kalliod/PGKB/Parempi idea.txt

Osta numeropadi eBaysta <10€, uudelleenmappaa näppäimet

Tehdään silti DIY-henkinen USB-HID-laite
