kalliod/PGKB/PCB/Rev 03.00/000018 PGKB Schematic Review.xlsx

Product: | 000018 PGKB Rev 1.00
Review date: | 2023-10-22
Reviewer: | Teemu Latonen
No | Item | Status | Comments
1 | Documentation
1.1 | New components checked for errors | Ok
1.2 | Schematic and test point comments | Ok
1.3 | Revision etc updated | Ok
1.4 | Change history page updated | Ok
2 | General design
2.1 | Check that floating pins are ok to be left floating | Ok
2.2 | Is there room for more bypass capacitors | Ok
2.3 | Design rules | Ok | Not very good
2.4 | Combine R and C values and sizes | Ok
3 | Digital circuits
3.1 | Impedance matching | Ok
3.2 | Logic voltage levels | Ok
3.3 | Logic timings during boot up | Ok
4 | Analog circuits
4.1 | Op amps: Offset voltage, bias current, speed, output load capability | Ok
 | Capacitive loading | Ok
4.2 | Input ranges for analog circuits | Ok
4.3 | Overvoltage situations | Ok
5 | Power circuits
5.1 | Power outputs are short circuit proof | Ok
5.2 | Power input is polarity protected | Ok
5.3 | Fuses and TVSs are added | No
6 | EMC
6.1 | Input and output signals are filtered | No
6.2 | Critical signals (RESET etc) are protected from EMI | Ok
6.3 | Fast signals are suppressed (e.g. high frequency clocks, SMPS) | Ok
6.4 | Emissions from SMPS are analyzed and proper countermeasures used | No
7 | Testing and production
7.1 | Test points, GND connection point | Ok
7.2 | 0 Ohm resistors to isolate circuits | Ok
7.3 | Alignment holes for tester | Ok
7.4 | All parts are RoHS compliant | NA
8 | BOM
8.1 | Component availability and lead times | Ok
