kalliod/PGKB/PCB/Rev 03.00/000018 PGKB Layout Review.xlsx

Product: | 000018 PGKB Rev 1.00
Review date: | 2023-10-22
Reviewer: | Teemu Latonen
No | Item | Status | Comments
1 | Markings
1.1 | PN, revision etc marked on board | Ok
1.2 | Area marked for UL and manufacturer markings | NA
1.3 | Layers marked for 4+ layer boards | Ok
1.4 | Reference designators | Ok
1.5 | PCB Build up in drill drawing | Ok
2 | Design
2.1 | Spark gaps and clearance cut outs | NA
2.2 | Fiducials | Ok
2.3 | Clerances and creepage distances checked | Ok
2.4 | Corners rounded (0.5 mm) | Ok
2.5 | Cable clearances, receptacles fit to connectors | Ok
2.6 | Component clearances | Ok
2.7 | Mounting holes | Ok
2.8 | PCB break away tabs | No
2.9 | Polarization of components (pin 1 marked, connectors labeled) | Ok
2.10 | No traces under conductive components | Ok
2.11 | No direct traces between adjacent pads of IC, if not covered by solder mask | Ok
2.12 | Tester guidance holes | Ok
2.13 | > 5 mm distance between test points | No
2.14 | Reset traces short | Ok
2.15 | Ground planes for analog circuits | Ok
2.16 | Impedance matching | Ok
2.17 | Area for heat sinks or exposed copper on PCB | Ok
2.18 | Wave soldering requirements | No
2.19 | Hand soldering requirements | Ok
3 | Documents
3.1 | BOM
3.2 | Gerbers
3.3 | Placement ASCII file
3.4 | Assembly drawing
3.5 | .pdfs of gerber files
3.6 | Drill files
4 | OTHER
4.1 | PCB and silk color
4.2 | Surface finish
4.3 | PCB specification file
4.4 | Mark the files with date
