kalliod/PGKB/ButtonSupport/Rev 01.00/ButtonSupport/Mechanical/buttonSupport.dxf

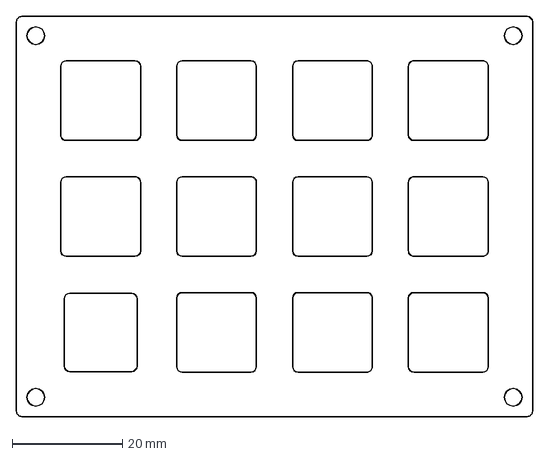
[picture p1: CAD file, 2023-10-17]
ButtonSupport/Rev 01.00/ButtonSupport/Mechanical/buttonSupport.dxf
93.5 x 72.5 mm
