kalliod/PGKB/Enclosure/Enclosure_bottom.stl

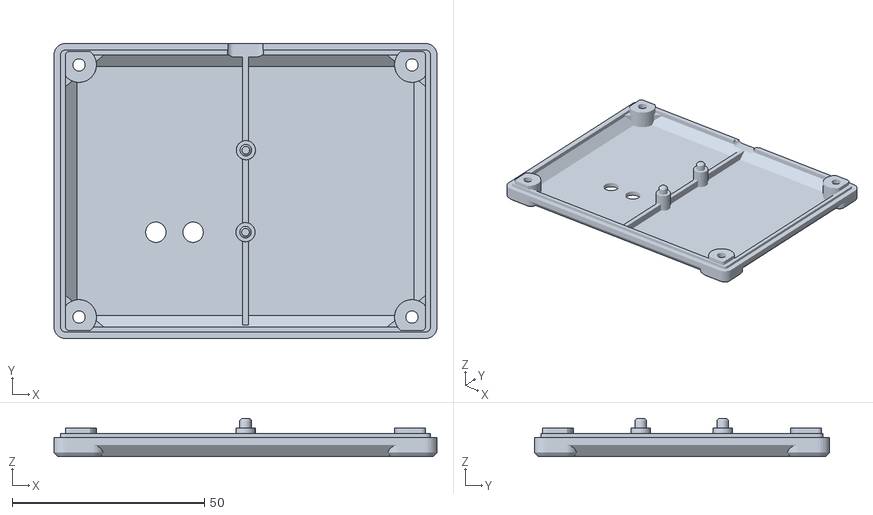
[picture p2: CAD file, 2024-08-26]
Enclosure/Enclosure_bottom.stl
99.5 x 76.7 x 9.90
