kalliod/PGKB/Enclosure/MX_Key_Template_Square v2.stl

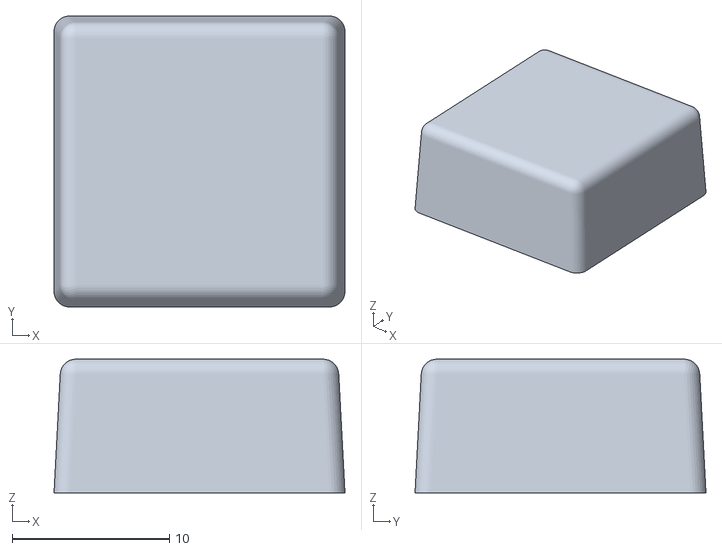
[picture p3: CAD file, 2024-08-26]
Enclosure/MX_Key_Template_Square v2.stl
18.5 x 18.5 x 8.50
