kalliod/PGKB/Enclosure/Encoder_knob.stl

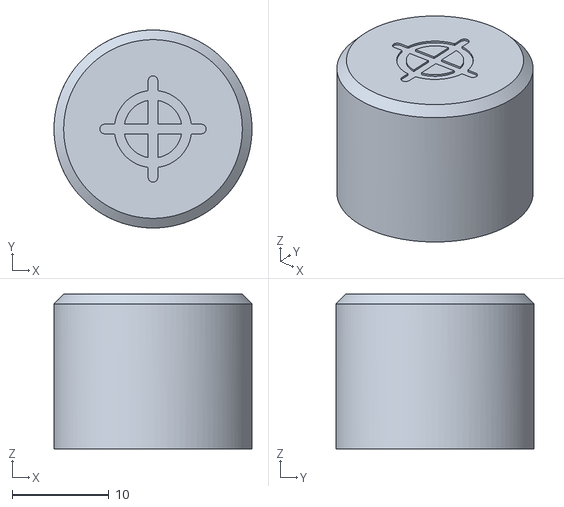
[picture p4: CAD file, 2024-08-26]
Enclosure/Encoder_knob.stl
20.5 x 20.5 x 16.0
