kalliod/PGKB/Enclosure/Enclosure_top.stl

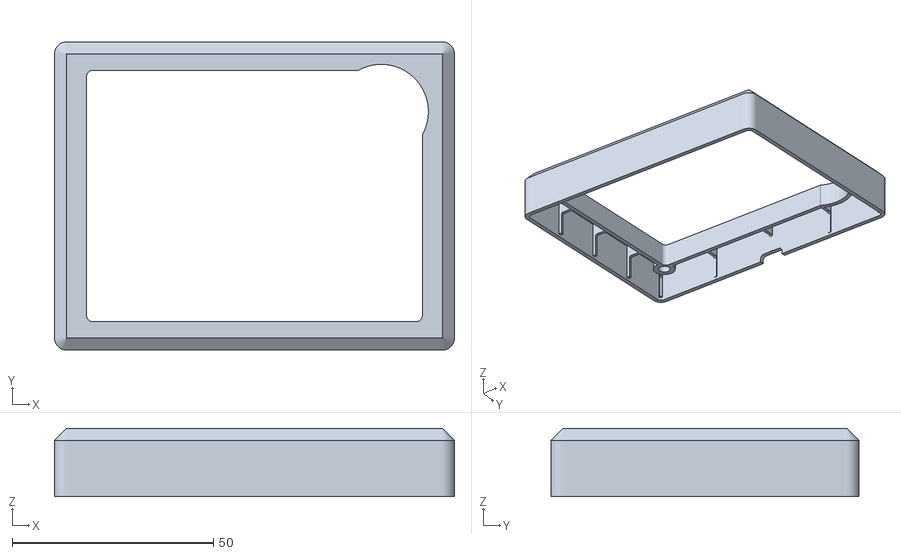
[picture p5: CAD file, 2024-08-26]
Enclosure/Enclosure_top.stl
99.5 x 76.7 x 17.0
