kalliod/PGKB/PCB/Rev 02.00/000018 PGKB/Mechanical/RST Button v1.stl

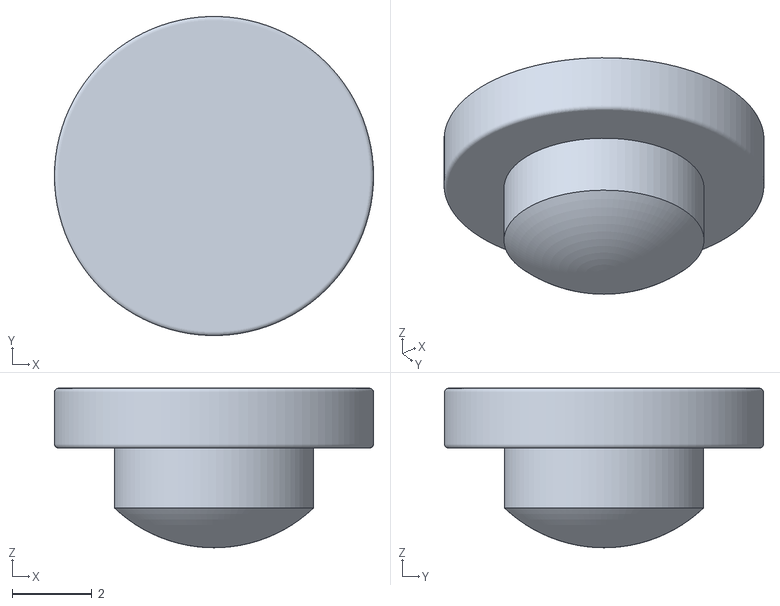
[picture p6: CAD file, 2024-08-26, an earlier design]
PCB/Rev 02.00/000018 PGKB/Mechanical/RST Button v1.stl
8.00 x 8.00 x 4.00
