kalliod/PGKB/PCB/Rev 02.00/000018 PGKB/Mechanical/Insert M3 D5 L5mm.stp

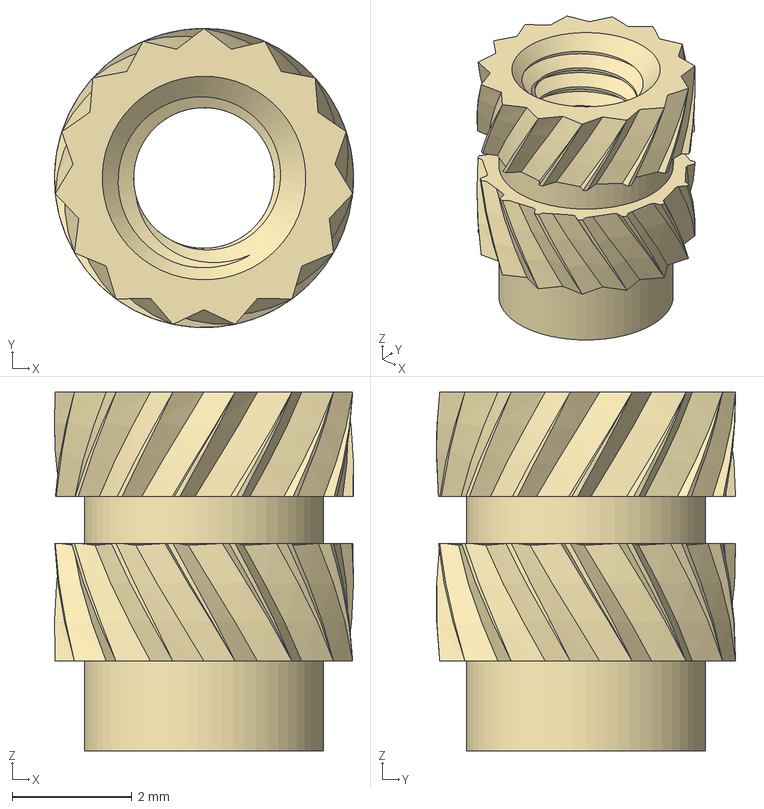
[picture p7: CAD file, 2023-10-23, an earlier design]
PCB/Rev 02.00/000018 PGKB/Mechanical/Insert M3 D5 L5mm.stp
5.00 x 5.00 x 6.00 mm
