kalliod/PGKB/PCB/Rev 02.00/000018 PGKB/Mechanical/Board Outline_V2.dxf

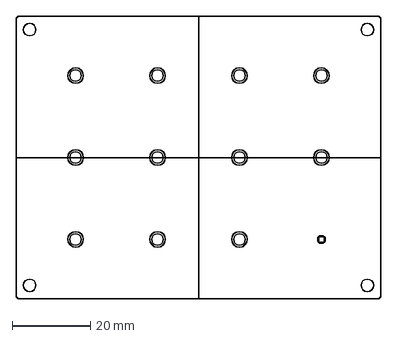
[picture p8: CAD file, 2023-10-17, an earlier design]
PCB/Rev 02.00/000018 PGKB/Mechanical/Board Outline_V2.dxf
93.5 x 72.5 mm
