kalliod/PGKB/PCB/Rev 02.00/000018 PGKB/Mechanical/Board Outline.dxf

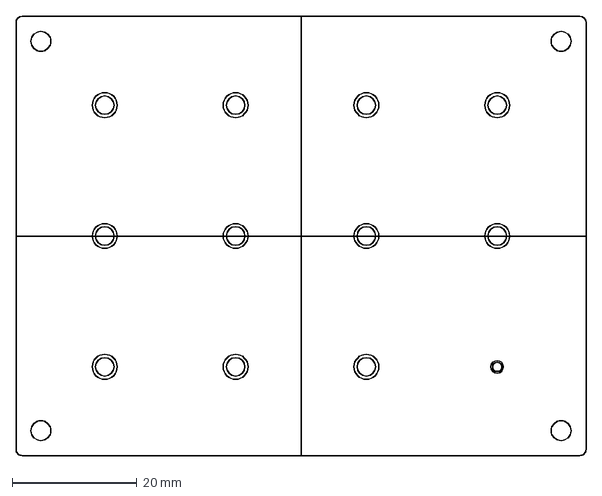
[picture p9: CAD file, 2023-10-16, an earlier design]
PCB/Rev 02.00/000018 PGKB/Mechanical/Board Outline.dxf
91.5 x 70.5 mm
