kalliod/PGKB/(list of files, cad)

Other CAD files:
PCB/Rev 02.00/000018 PGKB/Mechanical/Enclosure_top_V2.stl
PCB/Rev 02.00/000018 PGKB/Mechanical/Enclosure_top.step
PCB/Rev 02.00/000018 PGKB/Mechanical/MX_cap.stl
PCB/Rev 02.00/000018 PGKB/Mechanical/Enclosure_bottom_V2.stl
PCB/Rev 02.00/000018 PGKB/Mechanical/Enclosure_bottom.step
PCB/Rev 02.00/000018 PGKB/Mechanical/Encoder_knob.stl
Enclosure/Enclosure_bottom.f3d
Enclosure/Encoder_knob.f3d
Enclosure/MX_Key_Template_Square v2.f3d
PCB/Rev 02.00/000018 PGKB/Mechanical/Enclosure_bottom.stl
PCB/Rev 02.00/000018 PGKB/Mechanical/Enclosure_top.stl
