kalliod/PGKB/PCB/Rev 03.00/000018 PGKB/000018 PGKB Rev 3.pdf

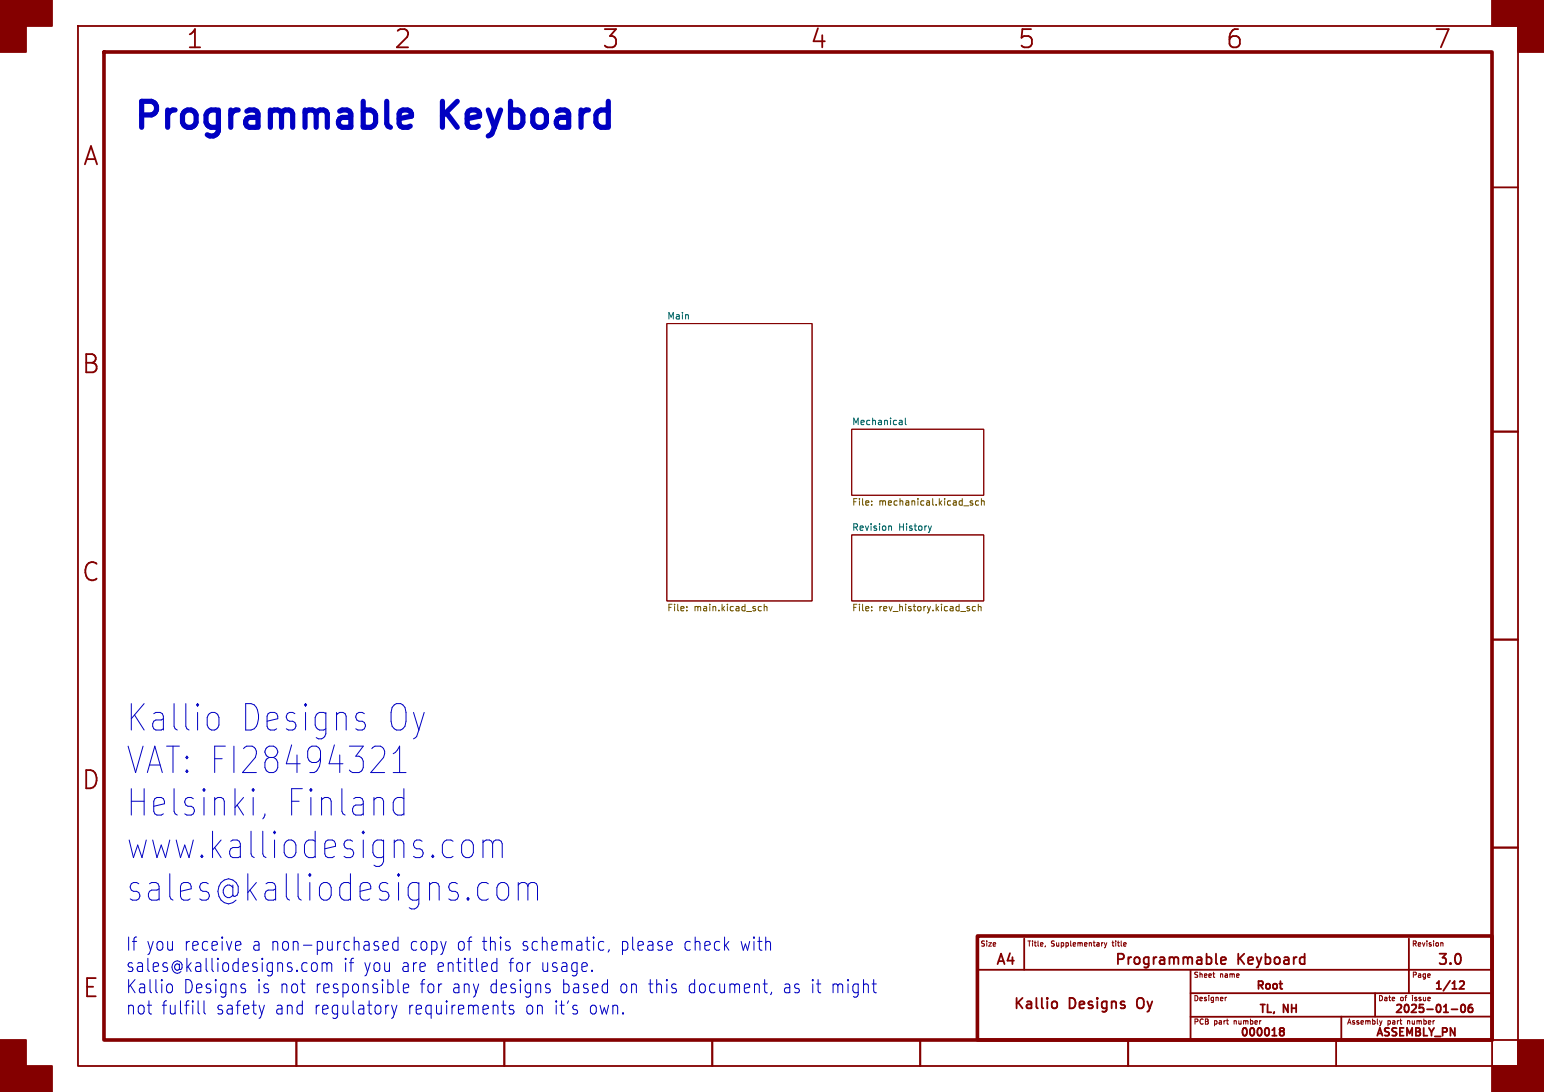
[picture p10: page 1]

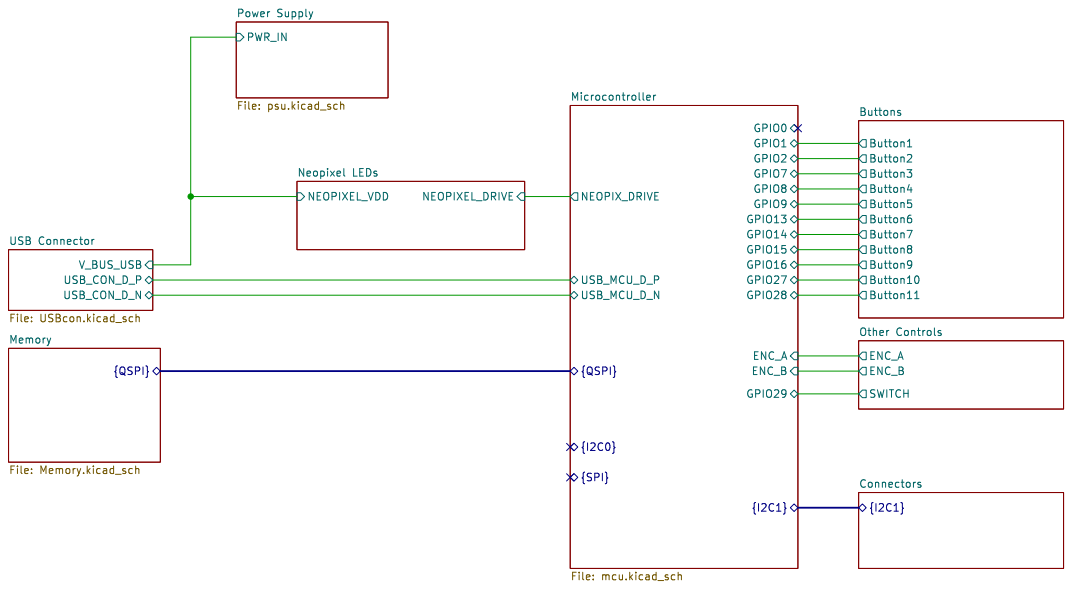
[picture p11: page 2]

Power Supply File: psu.kicad_sch
{I2C1} GPIO8 GPIO7 GPIO9 GPIO29 GPIO27 GPIO28 GPIO15 GPIO14 GPIO13 GPIO16 Microcontroller File: mcu.kicad_sch
{SPI} NEOPIX_DRIVE

USB Connector File: USBcon.kicad_sch

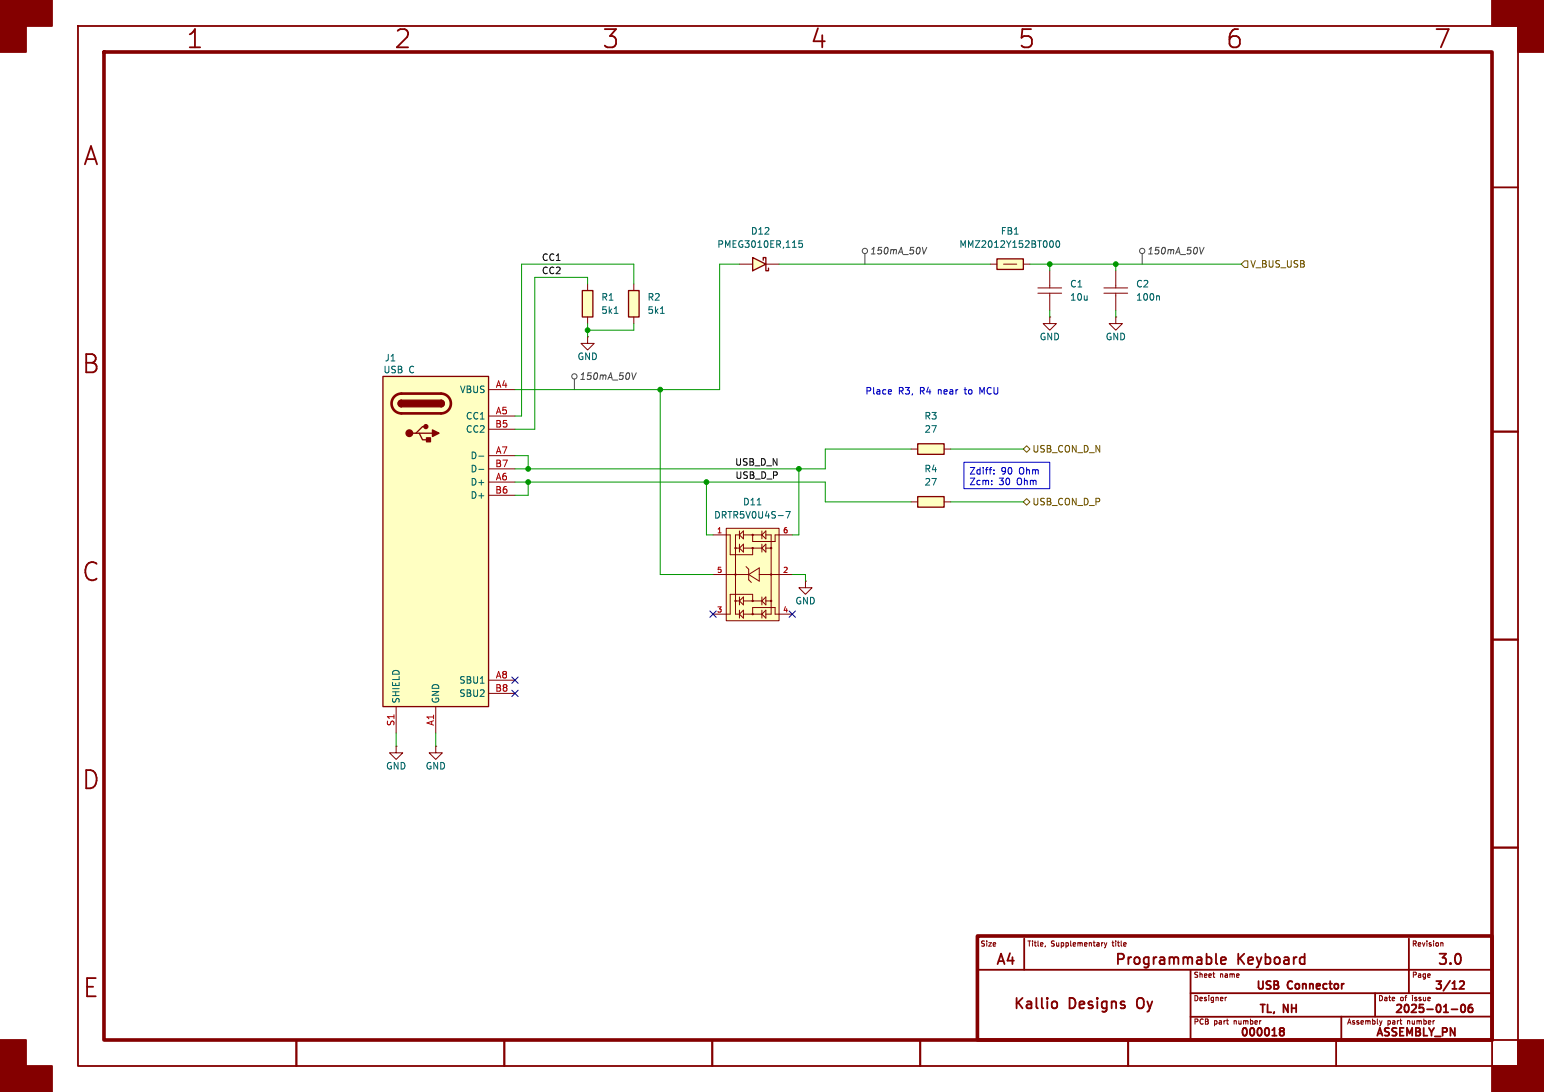
[picture p12: page 3]

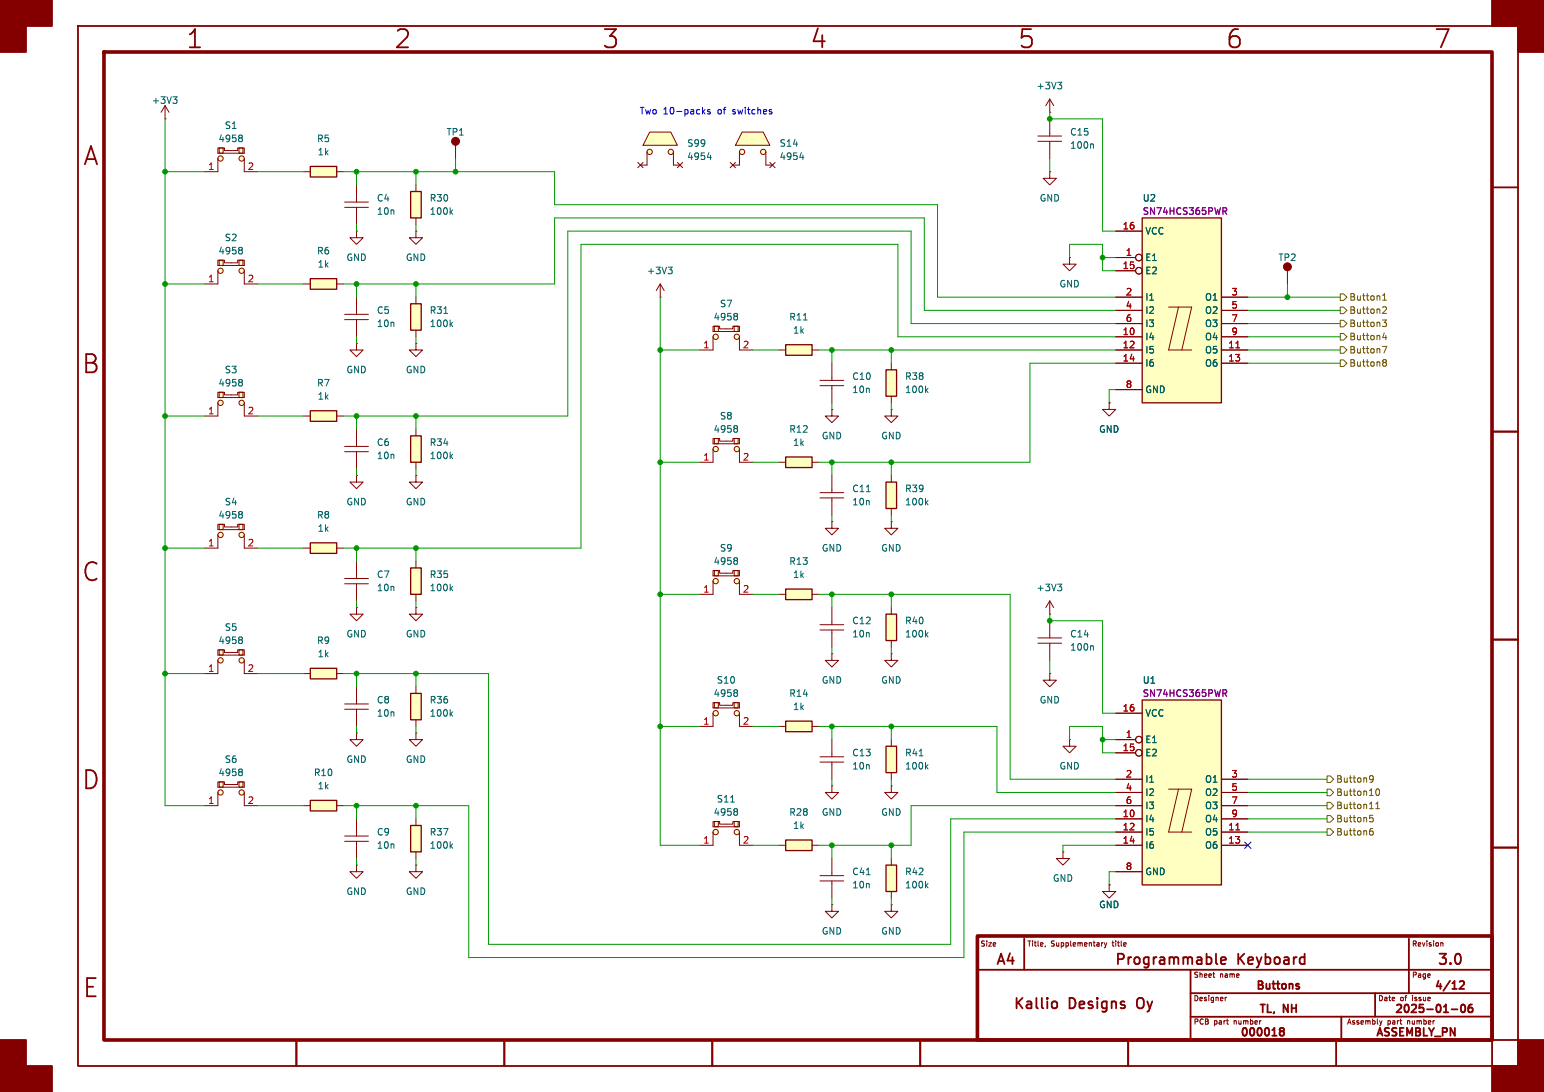
[picture p13: page 4]

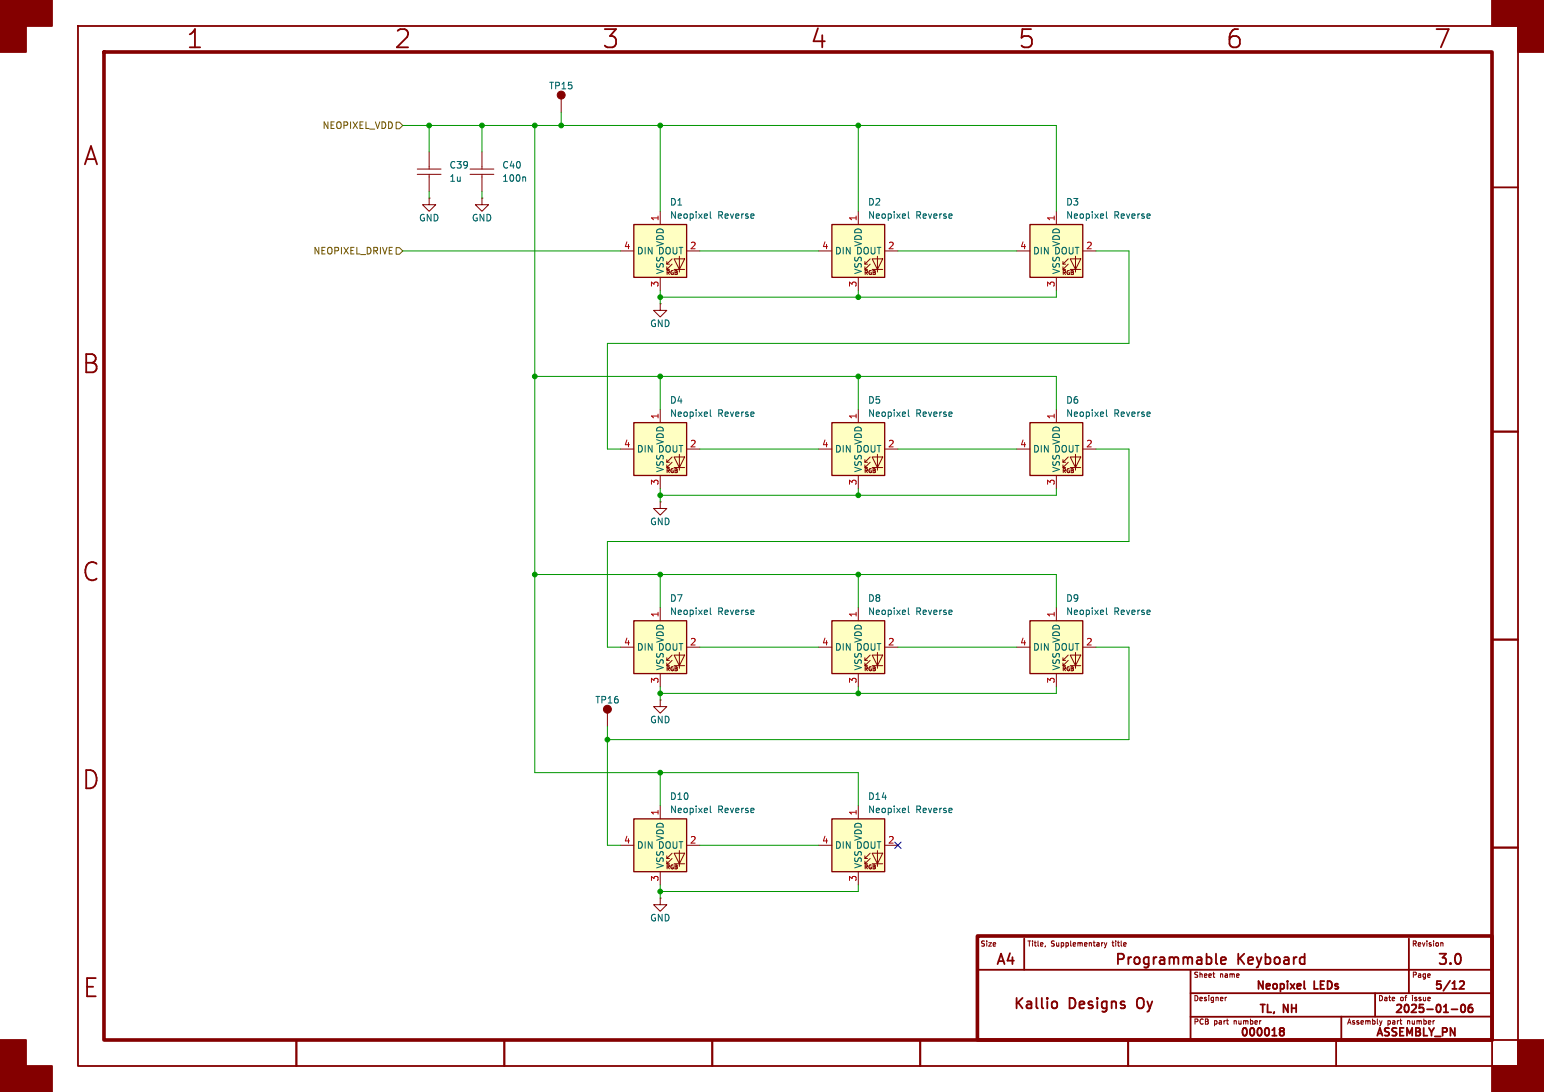
[picture p14: page 5]

3 DIN 4 D1 Neopixel Reverse GND
RGB VDD

3 DIN 4 D2 Neopixel Reverse GND

3 DIN 4 D5 Neopixel Reverse GND

3 DIN 4 D8 Neopixel Reverse GND

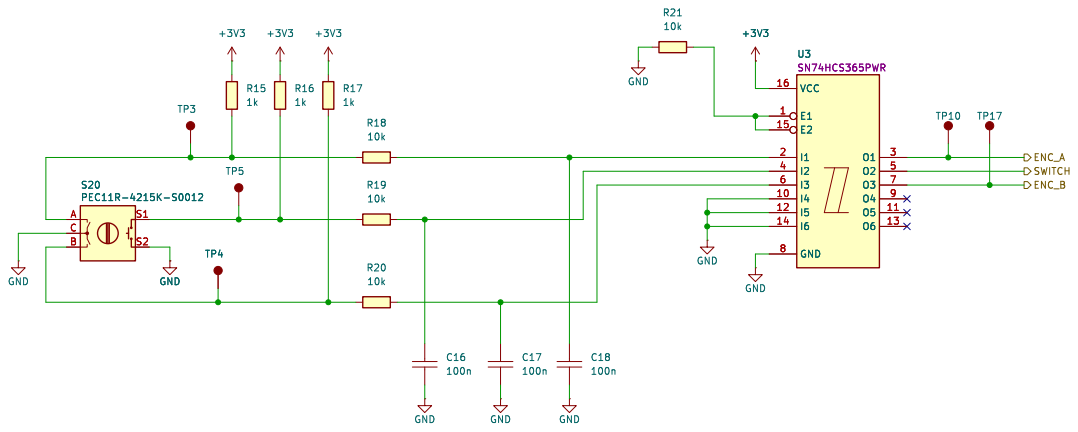
[picture p15: page 6]

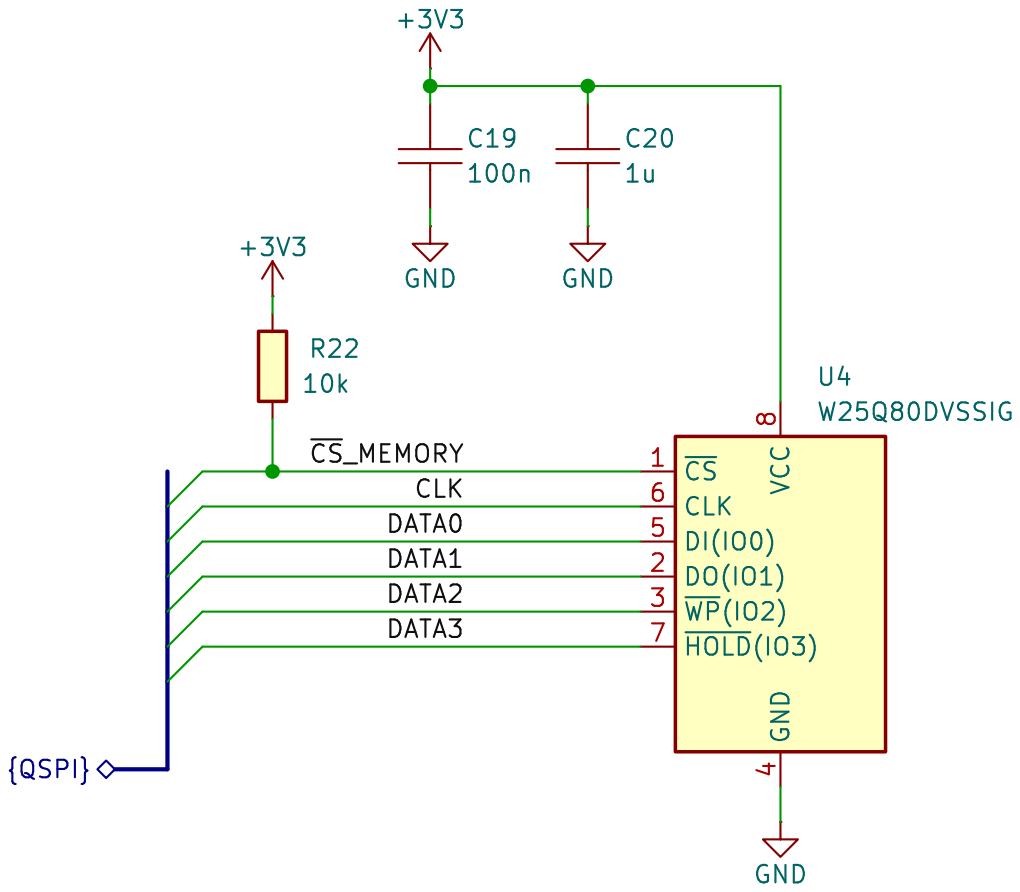
[picture p16: page 7]

4 DI(IO0) 5 CLK 6 ~{HOLD}(IO3) 7 VCC

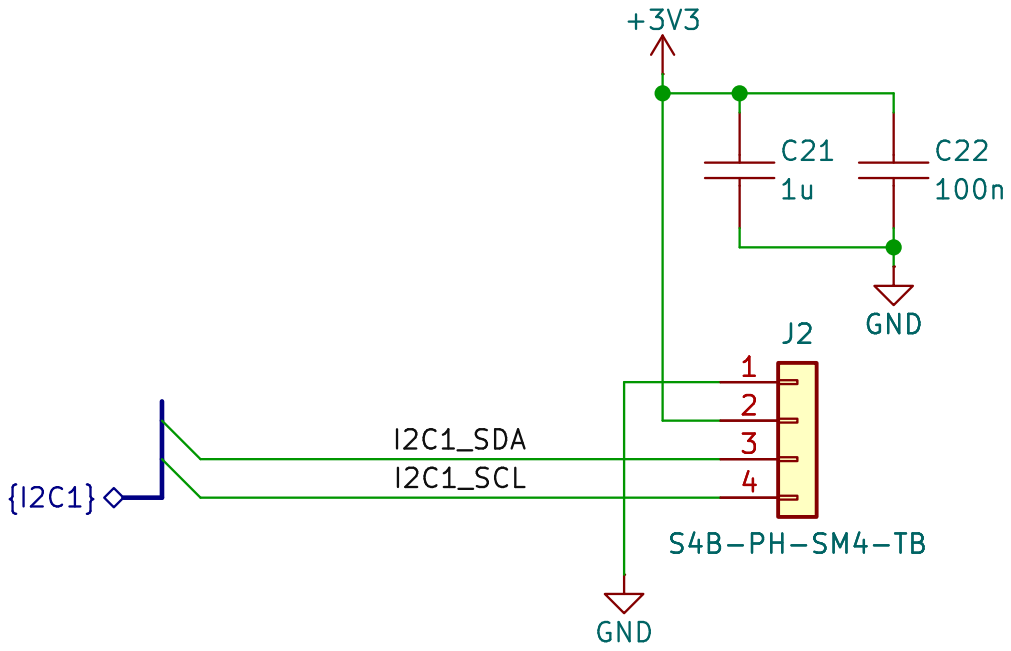
[picture p17: page 8]

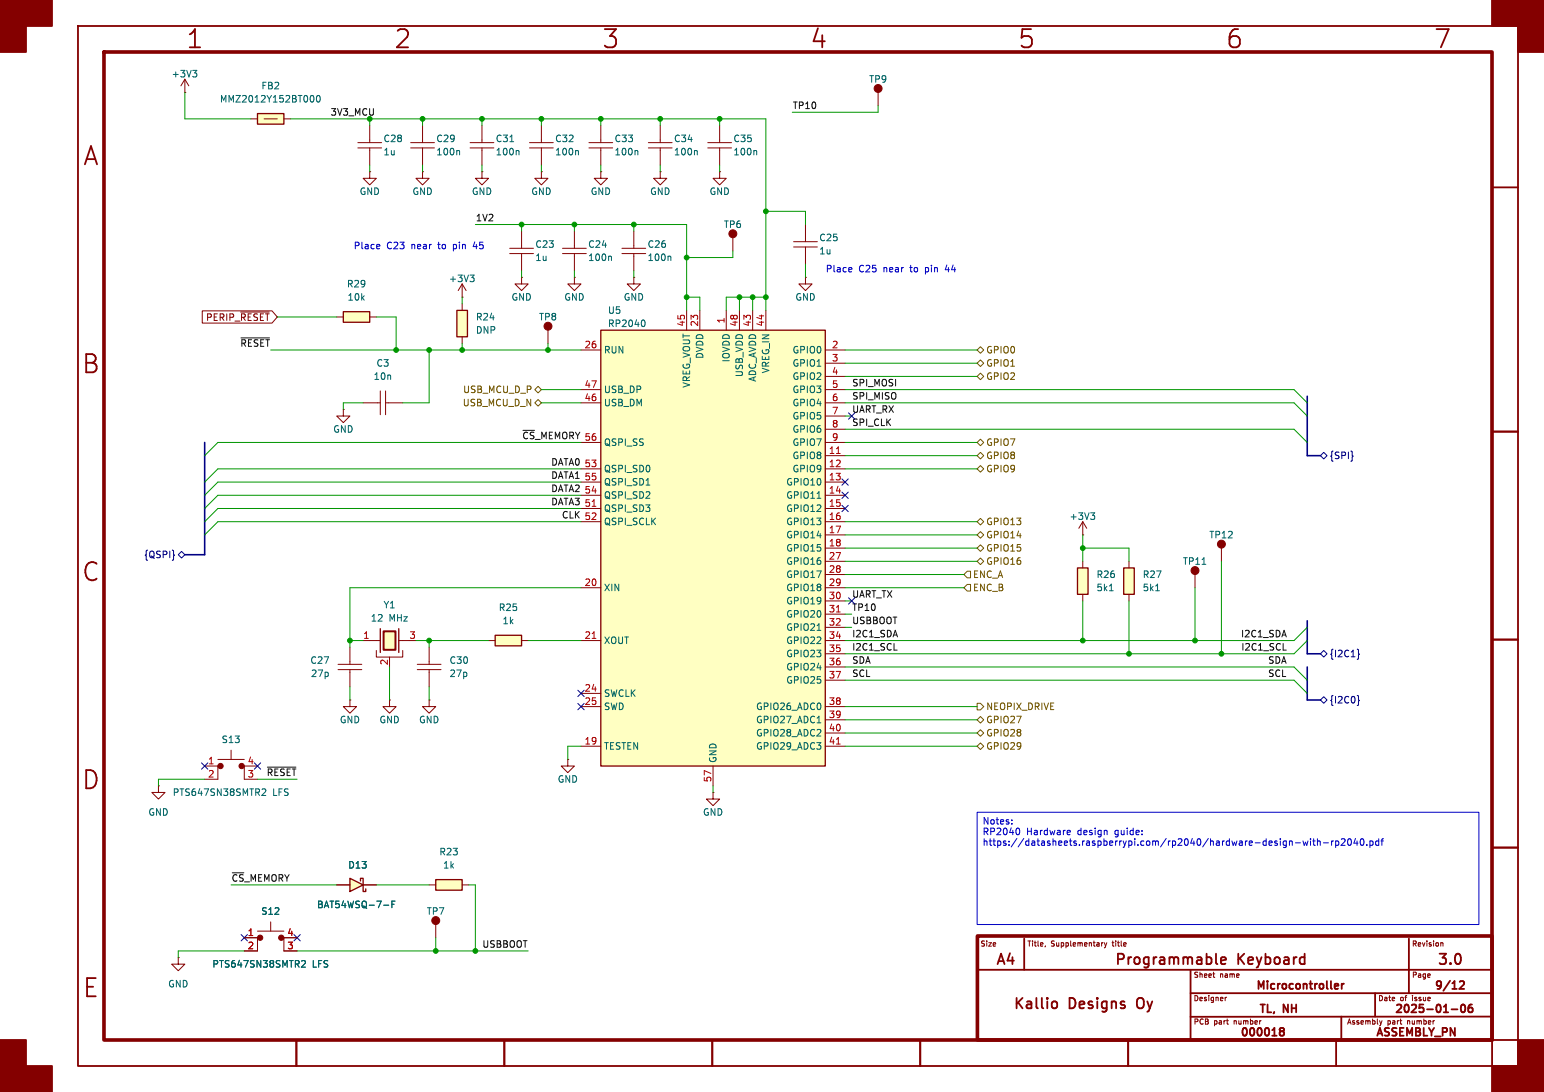
[picture p18: page 9]

1 GPIO8 11 GPIO9 12 GPIO10 13 GPIO11 14 GPIO12 15 GPIO13 16 GPIO14 17 GPIO15 18 TESTEN 19 GPIO0 2 XIN 20 XOUT 21 DVDD 23 SWCLK 24 SWD 25 RUN 26 GPIO16 27 GPIO17 28 GPIO18 29 GPIO1 3 GPIO19 30 GPIO20 31 GPIO21 32 GPIO22 34 GPIO23 35 GPIO24 36 GPIO25 37 GPIO26_ADC0 38 GPIO27_ADC1 39 GPIO2 4 GPIO28_ADC2 40 GPIO29_ADC3 41 ADC_AVDD 43 VREG_IN 44 VREG_VOUT 45 USB_DM 46 USB_DP 47 USB_VDD 48 GPIO3 5 QSPI_SD3 51 QSPI_SCLK 52 QSPI_SD0 53 QSPI_SD2 54 QSPI_SD1 55 QSPI_SS 56 GND 57 GPIO4 6 GPIO5 7 GPIO6 8 GPIO7 9 U5 RP2040 D13 BAT54WSQ-7-F

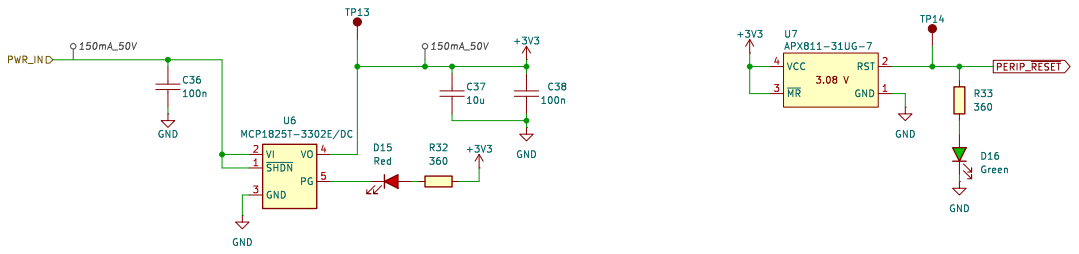
[picture p19: page 10]

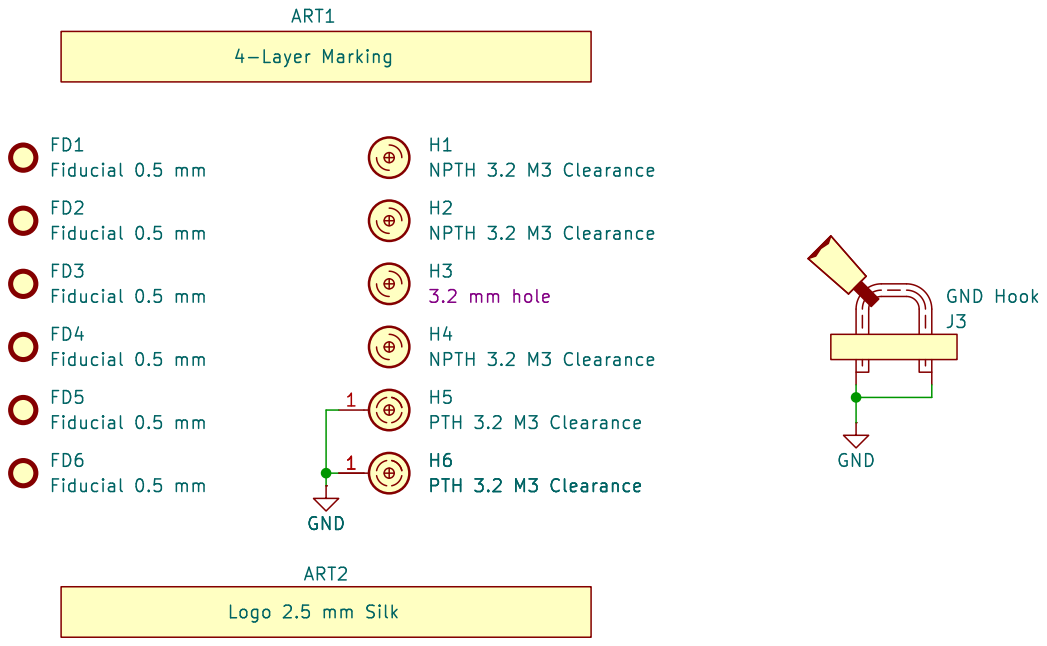
[picture p20: page 11]

Logo 2.5 mm Silk GND

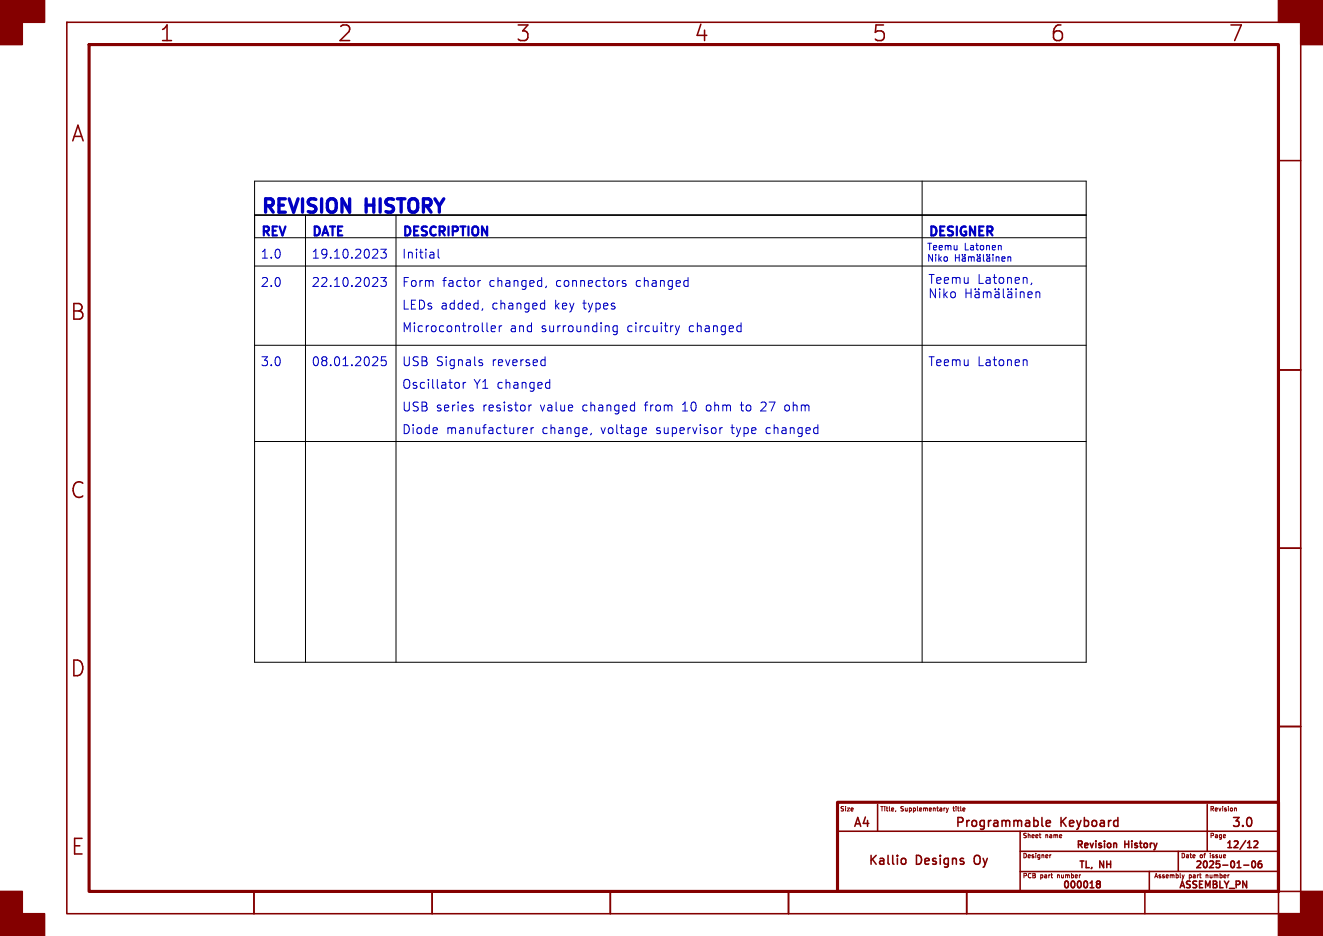
[picture p21: page 12]

2.0 | 08.01.2025 22.10.2023 | Teemu Latonen 3.0 Teemu Latonen,

Teemu Latonen
