kalliod/PGKB/PCB/Rev 01.01/000018 PGKB Rev 2.00.pdf

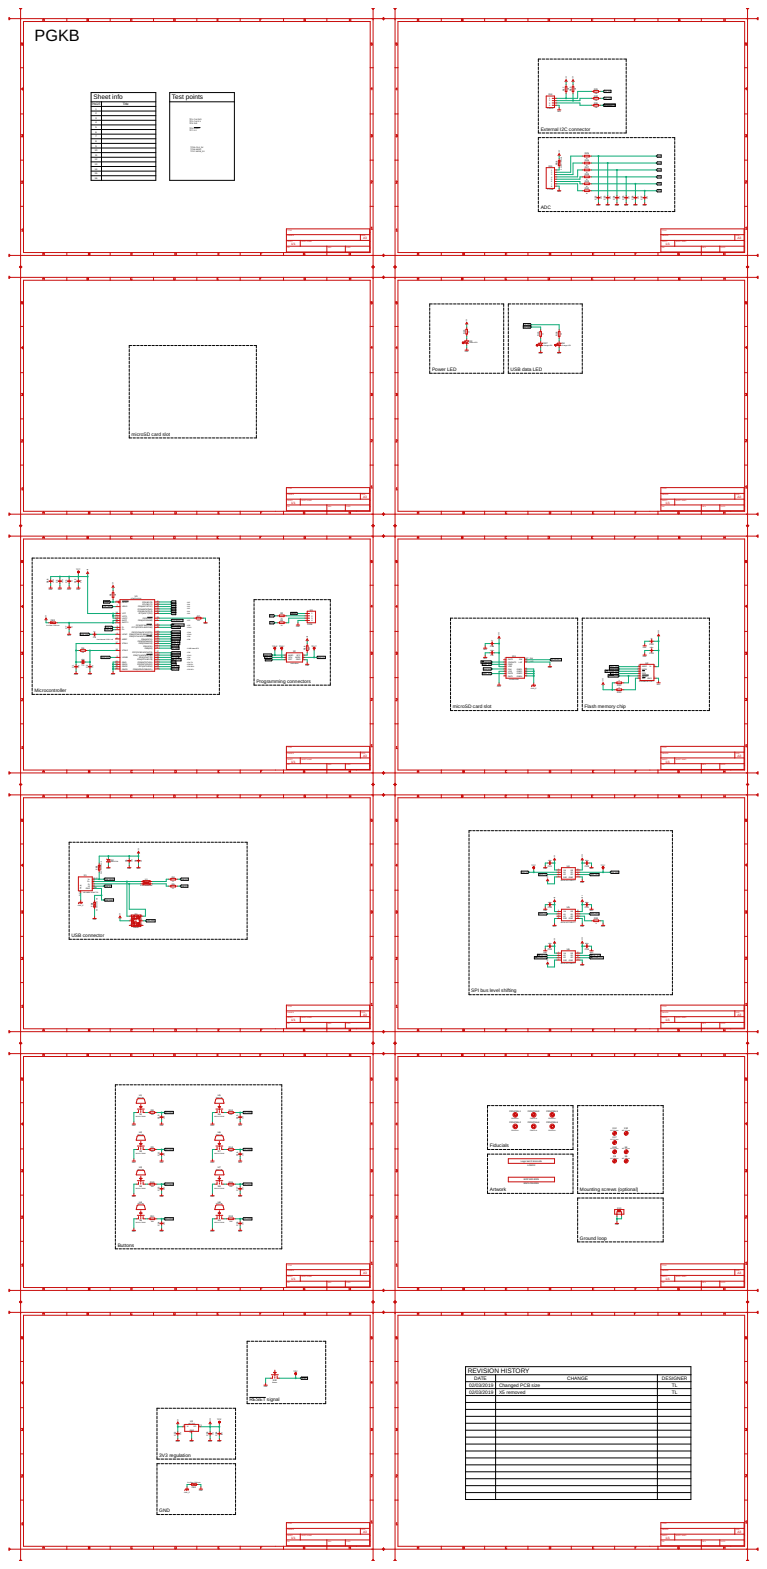
[picture p22: page 1]

OWNER: | SIZE: A3

SHEET: PN: | REV: DATE: SHEET NAME: 1/1

SPI bus level shifting

DATE | CHANGE | DESIGNER
02/03/2019 | Changed PCB size | TL
02/03/2019 | X5 removed | TL
