kalliod/PGKB/PCB/Rev 03.00/000018 PGKB/000018 PGKB.kicad_pcb

## KiCad design PCB/Rev 03.00/000018 PGKB/000018 PGKB.kicad_pcb (2025-01-08)

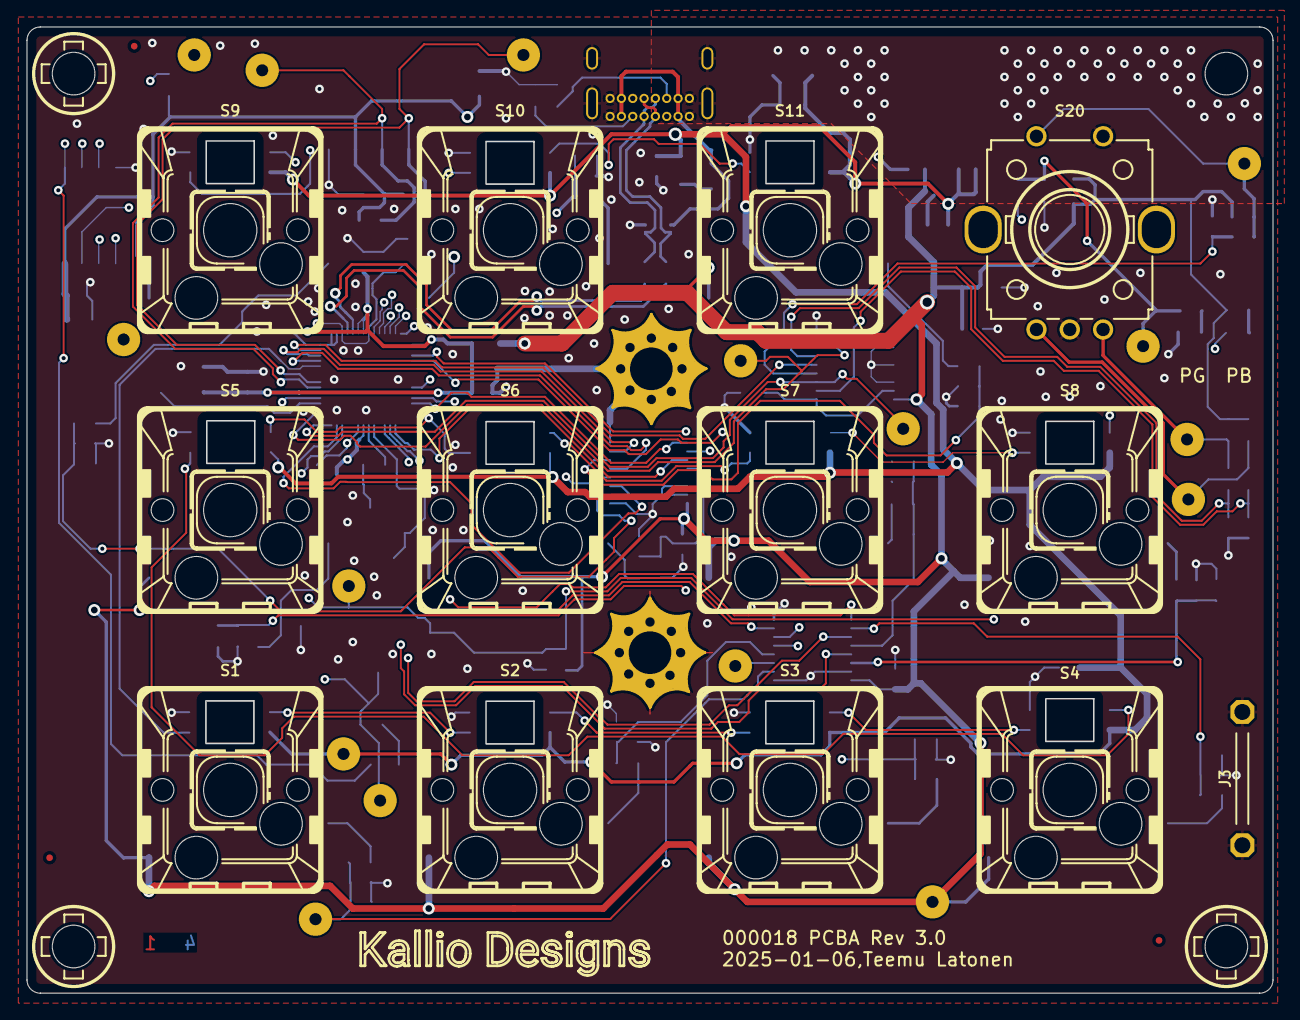
[picture p23: board 000018 PGKB.kicad_pcb from above]

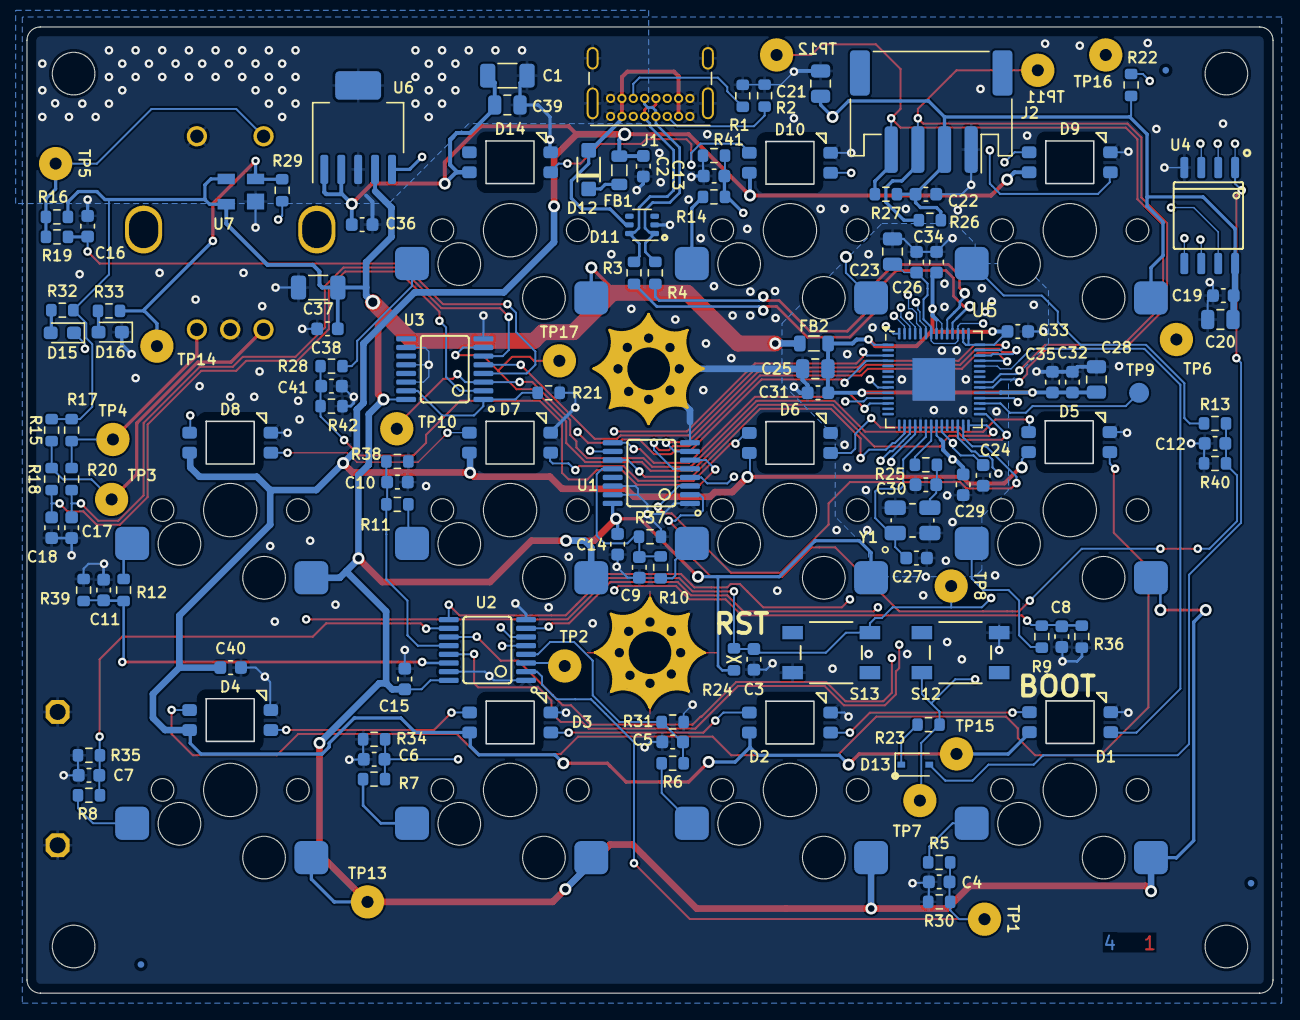
[picture p24: board 000018 PGKB.kicad_pcb from below]

Board: 4 copper layers, 93.5 x 72.5 mm, 157 parts (133 on the bottom side), 86 nets.

Parts:
ART1: 4-Layer Marking; ART_4-LAYER
ART2: Logo 2.5 mm Silk; ART_LOGO_TEXT_2.5MM_SILK
C1, C37: 10u; CAPC3216X150N
C2, C14, C15, C16, C17, C18, C19, C22, C24, C26, C29, C31, C32, C33, C34, C35, C36, C38, C40: 100n; CAPC1608X90N
C3, C4, C5, C6, C7, C8, C9, C10, C11, C12, C13, C41: 10n; CAPC1608X90N
C20, C21, C23, C25, C28, C39: 1u; CAPC2012X135N
C27, C30: 27p; CAPC1608X90N
D1, D2, D3, D4, D5, D6, D7, D8, D9, D10, D14: Neopixel Reverse; LEDM_NEO3535_REVERSE_SK6812-E
D11: DRTR5V0U4S-7; SOT-363_SC-70-6
D12: PMEG3010ER,115; DIOC360X180X150N_A
D13: BAT54WS; D_SOD-323
D15: Red; LEDM1608X70M
D16: Green; LEDM1608X70M
FB1, FB2: MMZ2012Y152BT000; INDC2016X100N
FD1, FD2, FD3, FD4, FD5, FD6: Fiducial 0.5 mm; Fiducial_0.5mm_Mask1mm
H1, H2, H4: NPTH 3.2 M3 Clearance; NPTH_3.2mm_M3_clearance
H3: NPTH_3.2; NPTH_3.2mm
H5, H6: PTH 3.2 M3 Clearance; PTH_3.2mm_M3_clearance_B
J1: USB C; USB_C_Receptacle_GCT_USB4085
J2: S4B-PH-SM4-TB; JST_PH_S4B-PH-SM4-TB_1x04-1MP_P2.00mm_Horizontal
J3: GND Hook; GND_HOOK_M
R1, R2, R26, R27: 5k1; RESC1608X55N
R3, R4: 27; RESC1608X55N
R5, R6, R7, R8, R9, R10, R11, R12, R13, R14, R15, R16, R17, R23, R25, R28: 1k; RESC1608X55N
R18, R19, R20, R21, R22, R29: 10k; RESC1608X55N
R24: DNP; RESC1608X55N_DNP
R30, R31, R34, R35, R36, R37, R38, R39, R40, R41, R42: 100k; RESC1608X55N
R32, R33: 360; RESC1608X55N
S1, S2, S3, S4, S5, S6, S7, S8, S9, S10, S11: 4958; SWITCH_BUTTON_Kailh_mx_socket
S12, S13: PTS647SN38SMTR2 LFS; SW_Push_1P1T_NO_CK_PTS647SN50SMTR2LFS
S20: PEC11R-4215K-S0012; RotaryEncoder_Bourns_Vertical_PEC11R-4x15f-Sxxxx
TP1, TP2, TP3, TP4, TP5, TP6, TP7, TP8, TP10, TP11, TP12, TP13, TP14, TP15, TP16, TP17: TP D2.5 mm H0.9mm; TestPoint_Pad_D2.5mm_H0.9mm
TP9: TestPoint_1.5mm_Round; TestPoint_Pad_D1.5mm
U1, U2, U3: SN74HCS365PWR; SOP65P600X150-16N
U4: W25Q80DVSSIG; SOIC127P790X195-8N
U5: RP2040; QFN-56-1EP_7x7mm_P0.4mm_EP3.2x3.2mm
U6: MCP1825T-3302E/DC; SOT127P700X180-6N
U7: CAT811TTBI-GT3; SOT-143_TO-253_M
Y1: 12 MHz; OSCCC320X250X70_M

Connections:
+3V3: C14.1, C15.1, C19.1, C20.1, C21.1, C22.1, C37.1, C38.1, FB2.1, J2.2, R15.1, R16.1, R17.1, R22.1, R24.2, R26.1, R27.1, R32.2, S1.1, S2.1, S3.1, S4.1, S5.1, S6.1, S7.1, S8.1, S9.1, S10.1, S11.1, TP13.1, U1.16 (VCC), U2.16 (VCC), U3.16 (VCC), U4.8 (VCC), U6.4 (VO), U7.3 (~MR), U7.4 (VCC)
/Main/Buttons/Button1: TP2.1, U2.3 (O1), U5.3 (GPIO1)
/Main/Buttons/Button2: U2.5 (O2), U5.4 (GPIO2)
/Main/Buttons/Button3: U2.7 (O3), U5.9 (GPIO7)
/Main/Buttons/Button4: U2.9 (O4), U5.11 (GPIO8)
/Main/Buttons/Button5: U1.9 (O4), U5.12 (GPIO9)
/Main/Buttons/Button6: U1.11 (O5), U5.16 (GPIO13)
/Main/Buttons/Button7: U2.11 (O5), U5.17 (GPIO14)
/Main/Buttons/Button8: U2.13 (O6), U5.18 (GPIO15)
/Main/Buttons/Button9: U1.3 (O1), U5.27 (GPIO16)
/Main/Buttons/Button10: U1.5 (O2), U5.39 (GPIO27_ADC1)
/Main/Buttons/Button11: U1.7 (O3), U5.40 (GPIO28_ADC2)
/Main/Connectors/I2C1_SCL: J2.4, R27.2, TP12.1, U5.35 (GPIO23)
/Main/Connectors/I2C1_SDA: J2.3, R26.2, TP11.1, U5.34 (GPIO22)
/Main/Memory/CLK: U4.6 (CLK), U5.52 (QSPI_SCLK)
/Main/Memory/DATA0: U4.5 (DI(IO0)), U5.53 (QSPI_SD0)
/Main/Memory/DATA1: U4.2 (DO(IO1)), U5.55 (QSPI_SD1)
/Main/Memory/DATA2: U4.3 (~WP(IO2)), U5.54 (QSPI_SD2)
/Main/Memory/DATA3: U4.7 (~HOLD(IO3)), U5.51 (QSPI_SD3)
/Main/Memory/~CS_MEMORY: D13.2 (A), R22.2, U4.1 (~CS), U5.56 (QSPI_SS)
/Main/Microcontroller/1V2: C23.1, C24.1, C26.1, TP6.1, U5.23 (DVDD), U5.45 (VREG_VOUT), U5.50 (DVDD)
/Main/Microcontroller/3V3_MCU: C25.1, C28.1, C29.1, C31.1, C32.1, C33.1, C34.1, C35.1, FB2.2, U5.1 (IOVDD), U5.10 (IOVDD), U5.22 (IOVDD), U5.33 (IOVDD), U5.42 (IOVDD), U5.43 (ADC_AVDD), U5.44 (VREG_IN), U5.48 (USB_VDD), U5.49 (IOVDD)
/Main/Microcontroller/ENC_A: TP10.1, U3.3 (O1), U5.28 (GPIO17)
/Main/Microcontroller/ENC_B: TP17.1, U3.7 (O3), U5.29 (GPIO18)
/Main/Microcontroller/GPIO29: U3.5 (O2), U5.41 (GPIO29_ADC3)
/Main/Microcontroller/NEOPIX_DRIVE: D1.4 (DIN), U5.38 (GPIO26_ADC0)
/Main/Microcontroller/TP10: TP9.1, U5.31 (GPIO20)
/Main/Microcontroller/USBBOOT: R23.2, S12.3, TP7.1, U5.32 (GPIO21)
/Main/Microcontroller/USB_MCU_D_N: R3.2, U5.46 (USB_DM)
/Main/Microcontroller/USB_MCU_D_P: R4.2, U5.47 (USB_DP)
/Main/Microcontroller/~RESET: C3.2, R24.1, R29.2, S13.3, TP8.1, U5.26 (RUN)
/Main/Neopixel LEDs/NEOPIXEL_VDD: C1.1, C2.1, C36.1, C39.1, C40.1, D1.1 (VDD), D2.1 (VDD), D3.1 (VDD), D4.1 (VDD), D5.1 (VDD), D6.1 (VDD), D7.1 (VDD), D8.1 (VDD), D9.1 (VDD), D10.1 (VDD), D14.1 (VDD), FB1.2, TP15.1, U6.1 (~SHDN), U6.2 (VI)
/Main/USB Connector/CC1: J1.A5 (CC1), R2.1
/Main/USB Connector/CC2: J1.B5 (CC2), R1.1
/Main/USB Connector/USB_D_N: D11.6, J1.A7 (D-), J1.B7 (D-), R3.1
/Main/USB Connector/USB_D_P: D11.1, J1.A6 (D+), J1.B6 (D+), R4.1
GND: C1.2, C2.2, C3.1, C4.2, C5.2, C6.2, C7.2, C8.2, C9.2, C10.2, C11.2, C12.2, C13.2, C14.2, C15.2, C16.1, C17.1, C18.1, C19.2, C20.2, C21.2, C22.2, C23.2, C24.2, C25.2, C26.2, C27.2, C28.2, C29.2, C30.2, C31.2, C32.2, C33.2, C34.2, C35.2, C36.2, C37.2, C38.2, C39.2, C40.2, C41.2, D1.3 (VSS), D2.3 (VSS), D3.3 (VSS), D4.3 (VSS), D5.3 (VSS), D6.3 (VSS), D7.3 (VSS), D8.3 (VSS), D9.3 (VSS), D10.3 (VSS), D11.2 (V-), D14.3 (VSS), D16.1 (K), H5.1, H6.1, J1.A1 (GND), J1.A12 (GND), J1.B1 (GND), J1.B12 (GND), J1.S1 (SHIELD), J2.1, J3.1, J3.2 (Pin_1), R1.2, R2.2, R21.1, R30.2, R31.2, R34.2, R35.2, R36.2, R37.2, R38.2, R39.2, R40.2, R41.2, R42.2, S12.2, S13.2, S20.C, S20.S2, U1.1 (E1), U1.8 (GND), U1.14 (I6), U1.15 (E2), U2.1 (E1), U2.8 (GND), U2.15 (E2), U3.8 (GND), U3.10 (I4), U3.12 (I5), U3.14 (I6), U4.4 (GND), U5.19 (TESTEN), U5.57 (GND), U6.3 (GND), U6.6 (GND), U7.1 (GND), Y1.2 (GND), Y1.4 (GND)
unnamed: C30.1, R25.1, Y1.3
unnamed: D1.2 (DOUT), D2.4 (DIN)
unnamed: D2.2 (DOUT), D3.4 (DIN)
unnamed: D3.2 (DOUT), D4.4 (DIN)
unnamed: D4.2 (DOUT), D5.4 (DIN)
unnamed: D5.2 (DOUT), D6.4 (DIN)
unnamed: D6.2 (DOUT), D7.4 (DIN)
unnamed: D7.2 (DOUT), D8.4 (DIN)
unnamed: D8.2 (DOUT), D9.4 (DIN)
unnamed: D9.2 (DOUT), D10.4 (DIN), TP16.1
unnamed: D10.2 (DOUT), D14.4 (DIN)
unnamed: D11.5 (V+), D12.2 (A), J1.A4 (VBUS), J1.A9 (VBUS), J1.B4 (VBUS), J1.B9 (VBUS)
unnamed: D12.1 (K), FB1.1
unnamed: D13.1 (K), R23.1
unnamed: D15.2 (A), R32.1
unnamed: D15.1 (K), U6.5 (PG)
unnamed: D16.2 (A), R33.1
unnamed: R5.1, S1.2
unnamed: R6.1, S2.2
unnamed: R7.1, S3.2
unnamed: R8.1, S4.2
unnamed: R9.1, S5.2
unnamed: R10.1, S6.2
unnamed: R11.1, S7.2
unnamed: R12.1, S8.2
unnamed: R13.1, S9.2
unnamed: R14.1, S10.2
unnamed: R15.2, R18.1, S20.A, TP3.1
unnamed: R16.2, R19.1, S20.S1, TP5.1
unnamed: R17.2, R20.1, S20.B, TP4.1
unnamed: R28.1, S11.2
unnamed: C12.1, R13.2, R40.1, U1.2 (I1)
unnamed: C13.1, R14.2, R41.1, U1.4 (I2)
unnamed: C41.1, R28.2, R42.1, U1.6 (I3)
unnamed: C8.1, R9.2, R36.1, U1.10 (I4)
unnamed: C9.1, R10.2, R37.1, U1.12 (I5)
unnamed: C4.1, R5.2, R30.1, TP1.1, U2.2 (I1)
unnamed: C5.1, R6.2, R31.1, U2.4 (I2)
unnamed: C6.1, R7.2, R34.1, U2.6 (I3)
unnamed: C7.1, R8.2, R35.1, U2.10 (I4)
unnamed: C10.1, R11.2, R38.1, U2.12 (I5)
unnamed: C11.1, R12.2, R39.1, U2.14 (I6)
unnamed: R21.2, U3.1 (E1), U3.15 (E2)
unnamed: C18.2, R18.2, U3.2 (I1)
unnamed: C16.2, R19.2, U3.4 (I2)
unnamed: C17.2, R20.2, U3.6 (I3)
unnamed: C27.1, U5.20 (XIN), Y1.1
unnamed: R25.2, U5.21 (XOUT)
PERIP_~RESET: R29.1, R33.2, TP14.1, U7.2 (RST)
