kalliod/PGKB/PCB/Rev 01.00/000018 PGKB Rev 1.00.brd

## EAGLE design PCB/Rev 01.00/000018 PGKB Rev 1.00.brd (2023-10-08, an earlier design)

Schematic: 000018 PGKB Rev 1.00.sch

Parts:
C1, C2: C0805_18PF_50V_NP0; CAPC2012X160
C3, C4, C7, C8, C20, C46: C0805_1UF_50V_X5R; CAPC2012X160
C5, C9, C19, C21, C29, C30, C31, C33, C34, C44, C48: C0603_100NF_50V_X7R; CAPC1608X90
C6: C0805_10NF_50V_X7R; CAPC2012X160
C10, C11, C13, C14, C15, C16, C17, C18, C22, C23, C24, C25, C26, C27: C0805_1NF_50V_X7R; CAPC2012X160
C12: C0805_4.7UF_25V_X5R; CAPC2012X160
C28, C32: C1206_10UF_16V_Y5V; CAPC3216X200
D1: DIODE_TVS_5V_BI_824015; SOP95P280X120-6N
D2: DIODE_TVS_5V_SMAJ5.0A; DIOC530X280X230_SMA_A
D3: LED_0603_GREEN_CLEAR_APTD1608CGCK; LEDM1608X80N_DOME
D4, D27: LED_0603_AMBER_DIFF_LOQ976-PS-25; LEDM1608X80N
ENCLOSURE1: ENCLOSURE_BOPLA_BOP-500-9005-TOP; ENCLOSURE_BOPLA_BOP-500-9005
FB1, FB2, FB3, FB4, FB6: FERRITE_0805_0A5; RESC2012X50
FIDUCIAL1, FIDUCIAL2, FIDUCIAL3, FIDUCIAL4, FIDUCIAL5, FIDUCIAL6: FIDUCIAL
H1, H2, H3, H4, H5, H6, H7, H8: SWITCH_CAP_DSA_RELEG
L1: L_CHOKE_EXC-34CE670U; IND_CHOKE_EXC-34
LOGO2: ART_LOGO_TEXT_2.5MM-SILK; ART_LOGO_TEXT_2.5MM_SILK
R1, R7: R0805_10K_5%; RESC2012X50
R2, R3, R13, R18, R23, R25, R26, R27, R28, R29, R30: R0805_1K_1%; RESC2012X50
R4, R5: R0603_22; RESC1608X45N
R6: R0805_1M_5%; RESC2012X50
R8, R9, R10, R11, R12, R14, R15, R19, R21, R22, R31: R0805_200_1%; RESC2012X50
R16: R0402_DNP; RESC1005X35N
R17, R20: R0805_3K3_1%; RESC2012X50
R24, R32, R33: R0603_0; RESC1608X45N
S1, S3, S4, S5, S6, S7, S8, S9: SWITCH_BUTTON_MX1A-C1NW; SWITCH_BUTTON_CHERRY_MX
S10: SWITCH_MOM_SPST_FSM4JSMA; SWITCH_BUTTON_TE_FSM4JSMA
TP1, TP2, TP3, TP5, TP7, TP15, TP16, TP17: PAD_TEST_POINT-2.5/0.7_A; TEST_POINT_2.5MM_0.7HOLE_1SIDE
U1: IC_MCU_ATMEGA32U4-AU; QFP80P1000X1000X120-44R_N
U2: IC_MEM_FLASH_AT45DB321E; SOP127P800X175-8
U3: IC_REG_3V3_1A_NCP1117LPST33T3G; SOT223
U4, U5, U6: IC_LEVEL_SHIFTER_SN74LVC2T45; SOP65P400X130-8
X1: CON_USB_MICROB_UJ2-MIBH-4-SMT-TR-MAN; CON_USB_MICROB_UJ2-MIBH-4-SMT-TR_MAN
X2: CON_PROG_AVR_ISP-OFFSET_1X06; CON_PINHD_1X06_TH_OFFSET
X3: CON_1X04_TH_OFFSET_PADS-SILK; 1X04_TH_OFFSET
X4, X5, X6, X9, X10, X12, X17, X18: HOL_3.2/6.0_NP; MTG_NP_M3_320X600
X11: CON_MICROSD_MOLEX_5033981892-M; CON_MICROSD_MOLEX_5033981892_M
X13: PAD_TEST_GROUND_HOOK; PAD_GND_HOOK_M
X14: CON_CLAMP_PTSM_1X04_H_SMD; CON_PHOENIX_CONTACT_1702474
X15: CON_CLAMP_PTSM_1X08_H_SMD; CON_PHOENIX_CONTACT_1771088
Y1: OSC_CRYSTAL_16M_ABLS-16.000MHZ-B4-T-HC49; OSC_CRYSTAL_HC49/US

Connections:
!CS!_FLASH_3V3: U2.4 (!CS!), U6.6 (B2)
!CS!_FLASH_5V: U1.31 (PC6(OC3A/!OC4A!)), U6.3 (A2)
!CS!_SD_3V3: U6.7 (B1), X11.2 (CD/DAT3)
!CS!_SD_5V: U1.25 (PD4(ICP1/ADC8)), U6.2 (A1)
!RESET: R1.P$1 (1), S10.1, TP5.P$1, U1.13 (!RESET), X2.5 (RST), X3.1
!RESET!_3V3: R32.P$1 (1), U2.3 (!RESET!)
+3V3: C9.P$2 (2), C19.P$2 (2), C20.P$2 (2), C28.P$1 (1), C29.P$1 (1), C31.P$1 (1), C34.P$1 (1), C44.P$1 (1), C46.P$2 (2), R32.P$2 (2), R33.P$2 (2), TP3.P$1, U2.6 (V+), U3.2 (VO), U3.4 (VO), U4.8 (VB), U5.8 (VB), U6.8 (VB), X11.4 (VDD)
+5V: C3.P$1 (1), C4.P$1 (1), C5.P$1 (1), C6.P$1 (1), C12.P$1 (1), C21.P$2 (2), C30.P$2 (2), C32.P$1 (1), C33.P$2 (2), C48.P$1 (1), D1.5 (V+), D2.C (K), FB1.P$2 (2), FB3.P$1 (1), FB6.P$2 (2), R1.P$2 (2), R16.P$2 (2), R17.P$2 (2), R20.P$2 (2), R23.P$2 (2), TP7.P$1, U1.2 (UVCC), U1.14 (VCC), U1.34 (VCC1), U3.3 (VI), U4.1 (VA), U4.5 (DIR), U5.1 (VA), U6.1 (VA), U6.5 (DIR)
AD0: C22.P$1 (1), R25.P$2 (2), U1.36 (PF7(ADC7(TDI))
AD1: C23.P$1 (1), R26.P$2 (2), U1.37 (PF6(ADC6/TDO))
AD4: C24.P$1 (1), R27.P$2 (2), U1.38 (PF5(ADC5/TMS))
AD5: C25.P$1 (1), R28.P$2 (2), U1.39 (PF4(ADC4/TCK))
AD6: C26.P$1 (1), R29.P$2 (2), U1.40 (PF1(ADC1))
AD7: C27.P$1 (1), R30.P$2 (2), U1.41 (PF0(ADC0))
BUTTON1: C10.P$1 (1), R8.P$2 (2), U1.26 (PD6(T1/ADC9/!OC4D))
BUTTON2: C11.P$1 (1), R9.P$2 (2), U1.27 (PD7(OC4D/ADC10/T0))
BUTTON3: C13.P$1 (1), R10.P$2 (2), U1.28 (PB4(ADC11))
BUTTON4: C14.P$1 (1), R11.P$2 (2)
BUTTON5: C15.P$1 (1), R12.P$2 (2), U1.29 (PB5(OC1A/ADC12/!OC4B!))
BUTTON6: C16.P$1 (1), R14.P$2 (2), U1.30 (PB6(OC1B/OC4B/ADC13))
BUTTON7: C17.P$1 (1), R15.P$2 (2), U1.12 (PB7(OC0A/OC1C/RTS))
BUTTON8: C18.P$1 (1), R19.P$2 (2), U1.32 (PC7(ICP3/CLK0/OC4A))
CLK_3V3: TP1.P$1, U2.2 (SCK), U4.7 (B1), X11.5 (CLK)
CLK_5V: TP2.P$1, TP15.P$1, U1.9 (PB1(SCK)), U4.2 (A1), X2.3 (SCK)
GND: C1.P$2 (2), C2.P$2 (2), C3.P$2 (2), C4.P$2 (2), C5.P$2 (2), C6.P$2 (2), C7.P$2 (2), C9.P$1 (1), C10.P$2 (2), C11.P$2 (2), C12.P$2 (2), C13.P$2 (2), C14.P$2 (2), C15.P$2 (2), C16.P$2 (2), C17.P$2 (2), C18.P$2 (2), C19.P$1 (1), C20.P$1 (1), C21.P$1 (1), C22.P$2 (2), C23.P$2 (2), C24.P$2 (2), C25.P$2 (2), C26.P$2 (2), C27.P$2 (2), C28.P$2 (2), C29.P$2 (2), C30.P$1 (1), C31.P$2 (2), C32.P$2 (2), C33.P$1 (1), C34.P$2 (2), C44.P$2 (2), C46.P$1 (1), C48.P$2 (2), D2.A, D3.C (CATHODE), D4.C (CATHODE), D27.C (CATHODE), FB2.P$1 (1), FB4.P$1 (1), R7.P$2 (2), R24.P$2 (2), S1.1, S3.1, S4.1, S5.1, S6.1, S7.1, S8.1, S9.1, S10.3, U1.15 (GND), U1.23 (GND1), U1.35 (GND2), U1.43 (GND3), U2.7 (GND), U3.1 (GND), U4.4 (GND), U5.4 (GND), U5.5 (DIR), U6.4 (GND), X2.6 (GND), X3.4, X11.6 (VSS), X11.DET_LVR (LAT), X13.P$1, X13.P$2, X14.4, X15.8
GND_E: FB2.P$2 (2), X1.G1 (TAB), X1.G2 (TAB), X1.H1 (TAB), X1.H2 (TAB), X1.H3 (TAB), X1.H4 (TAB), X11.H1 (GND1), X11.H2 (GND2), X11.H3 (GND3), X11.H4 (GND4)
INTERRUPT7: R31.P$2 (2), U1.1 (PE6(INT.6/AIN0))
MISO_3V3: U2.8 (MISO), U5.7 (B1), X11.7 (DAT0)
MISO_5V: TP16.P$1, U1.11 (PB3(PDO/MISO)), U5.2 (A1), X2.1 (MISO)
MOSI_3V3: U2.1 (MOSI), U4.6 (B2), X11.3 (CMD)
MOSI_5V: TP17.P$1, U1.10 (PB2(PDI/MOSI)), U4.3 (A2), X2.4 (MOSI)
unnamed: D1.1, L1.A2, X1.D+
unnamed: D1.6, L1.B2, X1.D-
unnamed: C7.P$1 (1), FB3.P$2 (2), U1.24 (AVCC), U1.44 (AVCC1)
unnamed: D4.A (ANODE), R18.P$1 (1)
unnamed: C1.P$1 (1), R6.P$1 (1), U1.17 (XTAL1), Y1.2
unnamed: C2.P$1 (1), R6.P$2 (2), U1.16 (XTAL2), Y1.1
unnamed: C8.P$2 (2), U1.6 (UCAP)
unnamed: R2.P$2 (2), X3.2
unnamed: R3.P$2 (2), X3.3
unnamed: R7.P$1 (1), U1.33 (PE2(!HWB))
unnamed: D27.A (ANODE), R13.P$1 (1)
unnamed: R8.P$1 (1), S1.2
unnamed: R16.P$1 (1), X2.2 (VCC)
unnamed: R9.P$1 (1), S3.2
unnamed: R10.P$1 (1), S4.2
unnamed: R11.P$1 (1), S5.2
unnamed: R12.P$1 (1), S6.2
unnamed: R14.P$1 (1), S7.2
unnamed: R15.P$1 (1), S8.2
unnamed: R19.P$1 (1), S9.2
unnamed: L1.B1, R5.P$1 (1)
unnamed: L1.A1, R4.P$1 (1)
unnamed: R33.P$1 (1), U2.5 (!WP!)
unnamed: R17.P$1 (1), R21.P$1 (1), X14.1
unnamed: R20.P$1 (1), R22.P$1 (1), X14.2
unnamed: D3.A (ANODE), R23.P$1 (1)
unnamed: R24.P$1 (1), U5.6 (B2)
unnamed: FB6.P$1 (1), X15.1
unnamed: R27.P$1 (1), X15.4
unnamed: R28.P$1 (1), X15.5
unnamed: R31.P$1 (1), X14.3
unnamed: R25.P$1 (1), X15.2
unnamed: R26.P$1 (1), X15.3
unnamed: R29.P$1 (1), X15.6
unnamed: R30.P$1 (1), X15.7
RXD: R2.P$1 (1), U1.20 (PD2(INT2/RXD1))
RX_LED: R13.P$2 (2), U1.8 (PB0(SS))
SCL_5V: R21.P$2 (2), U1.18 (PD0(INT0/OC0B/SCL))
SDA_5V: R22.P$2 (2), U1.19 (PD1(INT1/SDA))
SD_DETECT: X11.DET_SW (SW)
TXD: R3.P$1 (1), U1.21 (PD3(INT3/TXD1))
TX_LED: R18.P$2 (2), U1.22 (PD5(XCK/CTS))
USB_D+: R4.P$2 (2), U1.4 (D+)
USB_D-: R5.P$2 (2), U1.3 (D-)
USB_GND: C8.P$1 (1), D1.2 (V-), FB4.P$2 (2), U1.5 (UGND), X1.GND
USB_ID: X1.ID
USB_VBUS: FB1.P$1 (1), U1.7 (VBUS), X1.VBUS (V+)

Notes on the sheet:
Fiducials
Artwork
Mounting screws (optional)
Ground loop
microSD card slot
Programming connectors
!RESET! signal
3V3 regulation
USB connector
SPI bus level shifting
GND
Microcontroller
USB data LED
Buttons
Flash memory chip
External I2C connector
// D2 SDA
// D3 SCL
// A0
// A1
// A4
// A5
// A6
// A7
// USB data LED
Power LED
ADC
Use internal 2.56 V ref
// D7
// D0 RX
// D1 TX
// D4
// D12
// D13
// D6
// D8
// D9
// D10
// D11
// D5

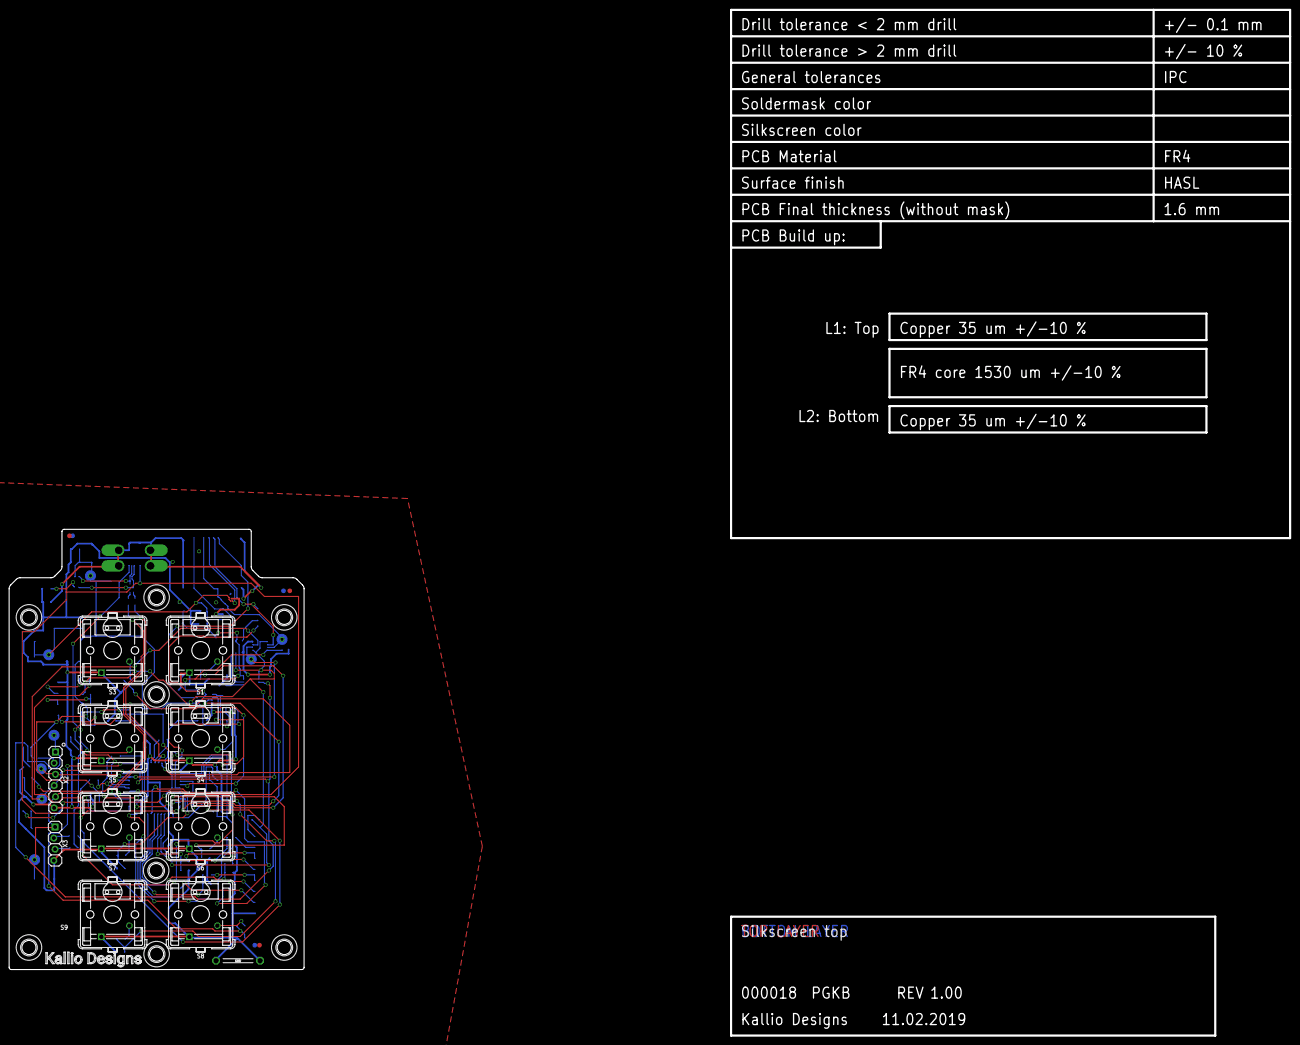
[picture p25: board 000018 PGKB Rev 1.00.brd from above]

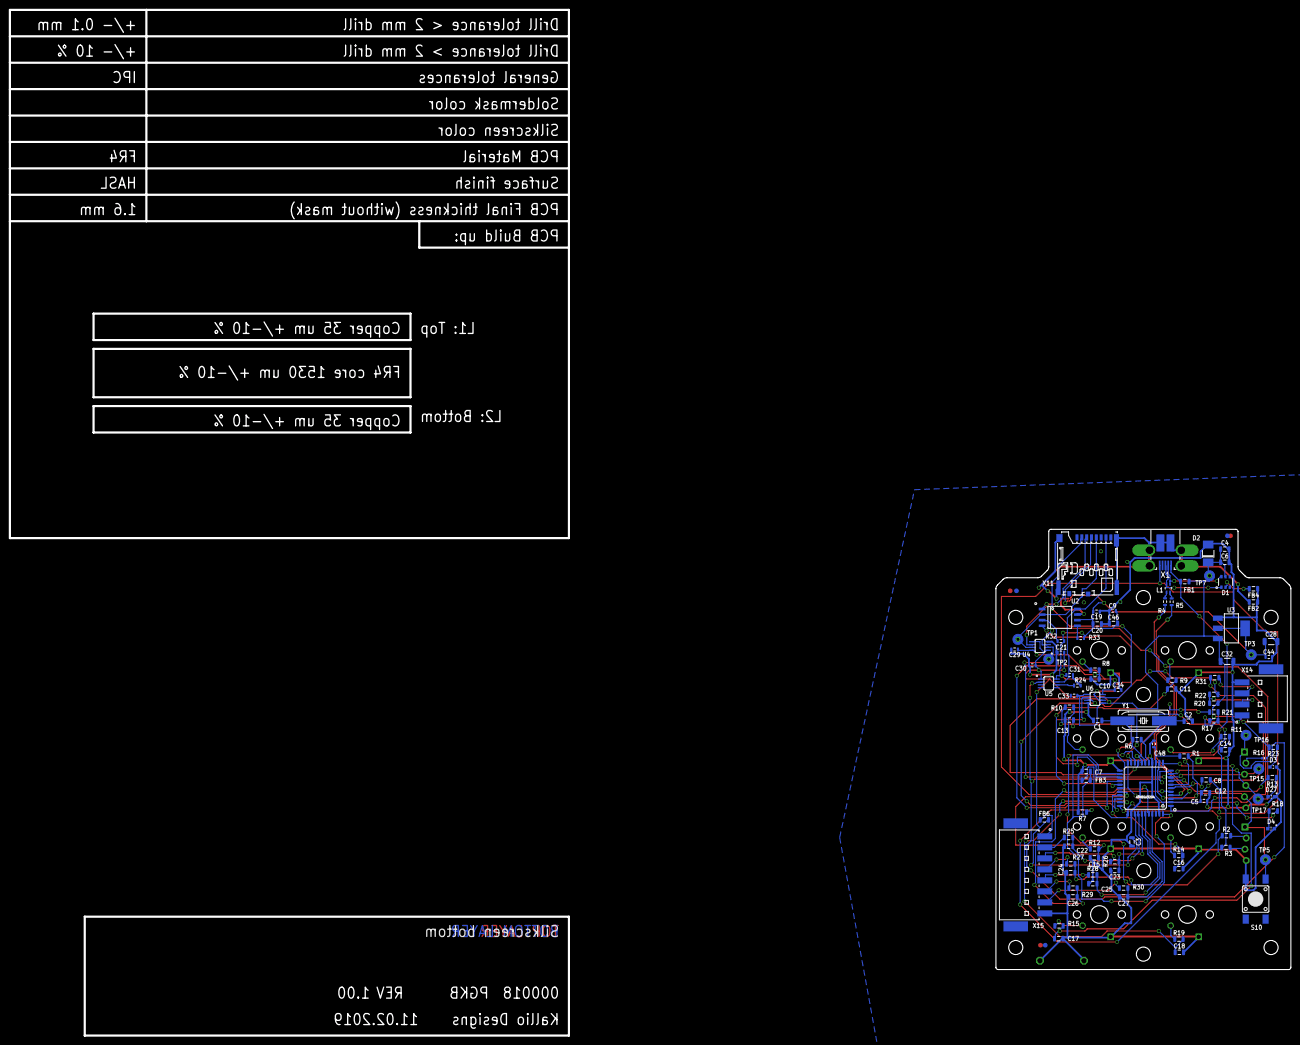
[picture p26: board 000018 PGKB Rev 1.00.brd from below]

Board: 2 copper layers, 67.0 x 100.0 mm, 136 parts (104 on the bottom side), 76 nets.
