kalliod/PGKB/FW/PKGBV2/PKBOARD.ino

#include "Keyboard.h"
#include <OneButton.h>


// Setup buttons
OneButton button1(28, true);
OneButton button2(29, true);

String incomingString = "S";
String functionM1 = "";

void setup() {


  button1.attachClick(Button_M1);
  button1.attachLongPressStop(Button_M1);

  button2.attachClick(Button_M2);
  button2.attachLongPressStop(Button_M2);

  // open the serial port:
  Serial.begin(9600);
  // initialize control over the keyboard:
  Keyboard.begin();
}

void loop() {

  // keep watching the push buttons
  button1.tick();
  button2.tick();
    // send data only when you receive data:
  if (Serial.available() > 0) {
    // read the incoming byte:
    incomingString = Serial.read();

    // say what you got:
    Serial.print("I received: ");
    Serial.println(incomingString);
  }
  }

void Button_M1()
{
  //Keyboard.press(KEY_LEFT_GUI);
  //Keyboard.press(KEY_LEFT_SHIFT);
  //Keyboard.write('h');
  Keyboard.print(incomingString);

  delay(10);
  Keyboard.releaseAll();
  Serial.println("pressed home");
}

// fit to view by pressing the middle mouse button twice
void Button_M2()
{
  Keyboard.write('S');
  Serial.println("pressed fit");
}
