kalliod/PGKB/(commit log)

2019-04-06 Country variants and buttons as array
    Can't really use modifier keys
2019-04-06 Bugfix
    All good again Finnish layout defined
    [PGKB_FW.ino]
2023-10-08 Rev 2 schematic started
    [000017 PGKB Rev 1.00 BOM.xlsm, 000018 PGKB Rev 1.00.brd, 000018 PGKB Rev 1.00.sch, 000018 PGKB Rev 2.00.brd, 000018 PGKB Rev 2.00.sch, 000018 PGKB.kicad_pcb, 000018 PGKB.kicad_sch, Memory.kicad_sch]
2023-10-16 Create Board Outline.dxf
    [Board Outline.dxf]
2023-10-17 Board outline update
    [Board Outline_V2.dxf, Button Support_V1.dxf]
2023-10-17 Update 000018 PGKB.kicad_pcb
    [000018 PGKB.kicad_pcb]
2023-10-17 sitte vaan routaus
    [000018 PGKB.kicad_pcb, USBcon.kicad_sch, buttons.kicad_sch, controls.kicad_sch]
2023-10-17 4L board
    [000018 PGKB.kicad_pcb, connectors.kicad_sch, mcu.kicad_sch]
2023-10-19 error fixing
    [000018 PGKB.csv, 000018 PGKB.kicad_pcb, 000018 PGKB.kicad_sch, LEDS_Neopixel.kicad_sch, Memory.kicad_sch, USBcon.kicad_sch, buttons.kicad_sch, connectors.kicad_sch]
2023-10-20 päivityksiä
    [000018 PGKB-B_Cu.gbl, 000018 PGKB-B_Fab.gbr, 000018 PGKB-B_Mask.gbs, 000018 PGKB-B_Paste.gbp, 000018 PGKB-B_Silkscreen.gbo, 000018 PGKB-Edge_Cuts.gm1, 000018 PGKB-F_Cu.gtl, 000018 PGKB-F_Fab.gbr]
2023-10-22 Review checklists
    [000018 PGKB Layout Review.xlsx, 000018 PGKB Schematic Review.xlsx, 000018 PGKB.kicad_pcb]
2023-10-23 USB connector moved
    [000018 PGKB.kicad_pcb]
2023-10-23 Create Insert M3 D5 L5mm.stp
    [Insert M3 D5 L5mm.stp]
2023-10-27 Button support
    [000018 PGKB-B_Cu.gbl, 000018 PGKB-B_Fab.gbr, 000018 PGKB-B_Mask.gbs, 000018 PGKB-B_Paste.gbp, 000018 PGKB-B_Silkscreen.gbo, 000018 PGKB-Edge_Cuts.gm1, 000018 PGKB-F_Cu.gtl, 000018 PGKB-F_Fab.gbr]
2023-10-27 PN added
    [000077 ButtonSupport.kicad_pcb, 000077 ButtonSupport.kicad_sch]
2024-01-24 mfg files
    [000018 PGKB Rev 1.00_Digi-Key.xlsx, 000018 PGKB.csv, 000018 PGKB.kicad_pcb, buttons.kicad_sch, mcu.kicad_sch]
2024-01-24 MODIFICATIONS To Rev 2
    [000018 PGKB.csv, 000018 PGKB.kicad_pcb, 000018 PGKB.kicad_sch, LEDS_Neopixel.kicad_sch, Memory.kicad_sch, USBcon.kicad_sch, buttons.kicad_sch, connectors.kicad_sch]
2024-01-24 MODIFICATIONS Updates
    [000018 PGKB Rev 1.00_Digi-Key.xlsx, 000018 PGKB Rev 2.00 BOM.csv, 000018 PGKB Rev 2.00 BOM.xlsx, 000018 PGKB.csv, 000018 PGKB.kicad_pcb, buttons.kicad_sch, mcu.kicad_sch]
2024-04-08 Updates started
    [000018 PGKB Layout Review.xlsx, 000018 PGKB Rev 2.00 BOM.csv, 000018 PGKB Rev 2.00 BOM.xlsx, 000018 PGKB Schematic Review.xlsx, 000018 PGKB.kicad_pcb, 000018 PGKB.kicad_sch, LEDS_Neopixel.kicad_sch, Memory.kicad_sch]
2024-05-04 Maybe new psu needed
    [000018 PGKB.kicad_sch, LEDS_Neopixel.kicad_sch, Memory.kicad_sch, USBcon.kicad_sch, buttons.kicad_sch, connectors.kicad_sch, controls.kicad_sch, main.kicad_sch]
2024-05-22 Update 000018 PGKB.kicad_pro
2024-07-14 Bugfixes for Rev 2
    Oscillator, USB reversed, USB series resistors values
    [000018 PGKB.kicad_sch, LEDS_Neopixel.kicad_sch, Memory.kicad_sch, USBcon.kicad_sch, buttons.kicad_sch, connectors.kicad_sch, controls.kicad_sch, main.kicad_sch]
2024-07-14 File version update
    [000018 PGKB.kicad_pcb]
2024-07-14 Update USBcon.kicad_sch
    Changed back to 0603 components
    [USBcon.kicad_sch]
2024-07-14 Updated layout from schematic
    [000018 PGKB.kicad_pcb, mcu.kicad_sch]
2024-07-14 routed all
    [000018 PGKB.kicad_pcb]
2024-07-14 Resolved DRC problems
    [000018 PGKB.kicad_pcb, LEDS_Neopixel.kicad_sch, Memory.kicad_sch, USBcon.kicad_sch, buttons.kicad_sch, connectors.kicad_sch, controls.kicad_sch, mcu.kicad_sch]
2024-07-15 Test points for encoder signals
    [000018 PGKB.kicad_pcb, controls.kicad_sch, mechanical.kicad_sch]
2024-07-15 Encoder Test points to layout
    [000018 PGKB.kicad_pcb]
2024-07-16 Signals renamed
    [000018 PGKB.kicad_pcb, main.kicad_sch, mcu.kicad_sch]
2024-07-16 GND hook added
    [000018 PGKB.kicad_pcb, mechanical.kicad_sch]
2024-08-18 Rev3 outputs
    [000018 PGKB Layout Review.xlsx, 000018 PGKB Rev 2.00 BOM.csv, 000018 PGKB Rev 2.00 BOM.xlsx, 000018 PGKB Rev 3.00 BOM.csv, 000018 PGKB Rev 3.00 BOM.xlsx, 000018 PGKB Schematic Review.xlsx, 000018 PGKB.kicad_pcb, 000018 PGKB.kicad_sch]
2024-08-18 Create 000018 PGKB Rev 3.00 BOM_purchasing.xlsx
    [000018 PGKB Rev 3.00 BOM_purchasing.xlsx]
2024-08-26 STL generated
    [Enclosure_bottom.f3d, Enclosure_bottom.step, Enclosure_bottom_V2.stl, Enclosure_top.step, Enclosure_top.stl, Enclosure_top_V2.stl, Encoder_knob.f3d, Encoder_knob.stl]
2024-08-26 update stl
    [Enclosure_bottom.stl, Encoder_knob.stl, MX_Key_Template_Square v2.stl]
2025-01-06 Rev 3 tekemista
    [000018 PGKB.kicad_pcb, 000018 PGKB.kicad_sch, LEDS_Neopixel.kicad_sch, Memory.kicad_sch, USBcon.kicad_sch, buttons.kicad_sch, connectors.kicad_sch, controls.kicad_sch]
2025-01-08 mfg outputs
    [000018 PGKB Rev 3.00 BOM.xlsx, 000018 PGKB Rev 3.00 BOM_purchasing.xlsx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]
2025-01-08 Update 000018 PGKB Rev 3.00 BOM_purchasing.xlsx
    [000018 PGKB Rev 3.00 BOM_purchasing.xlsx]
